Aarhus-University-MPE/Ice-Nucleation-Controller/src/Arduino/INCField/README.md

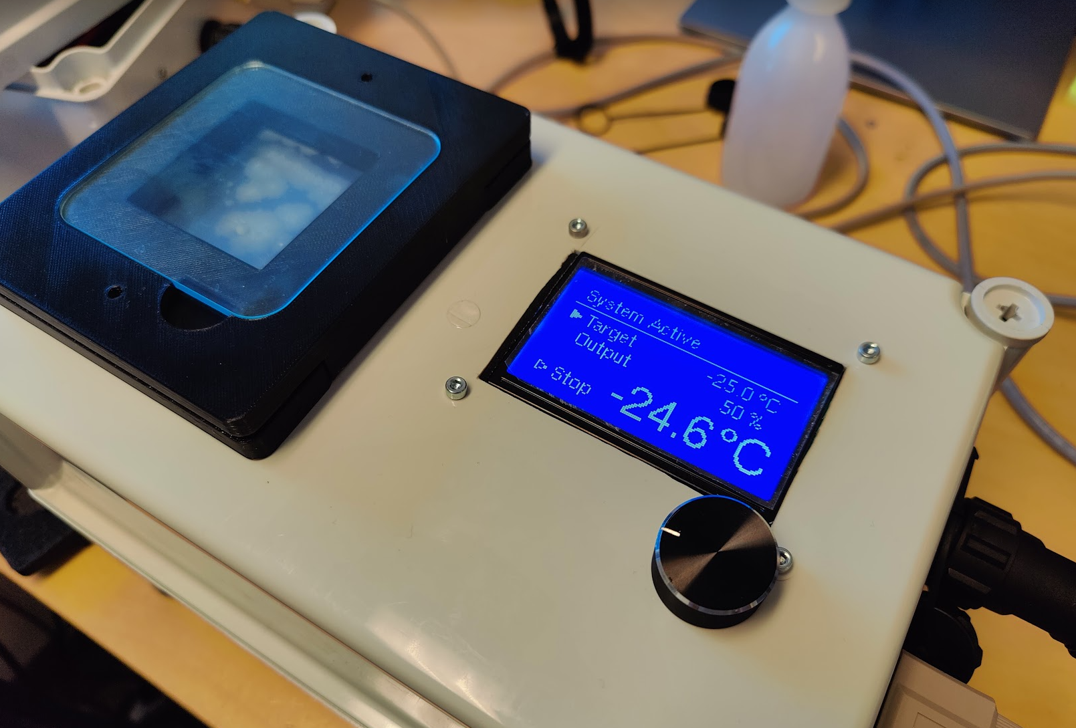
[picture p4: docs/assets/FieldController.png]


# Ice-Nucleation - Field Version

Reimagined Ice Nucleation system for field operation
