Aarhus-University-MPE/Ice-Nucleation-Controller/docs/assets/Cam_Tower_1.png

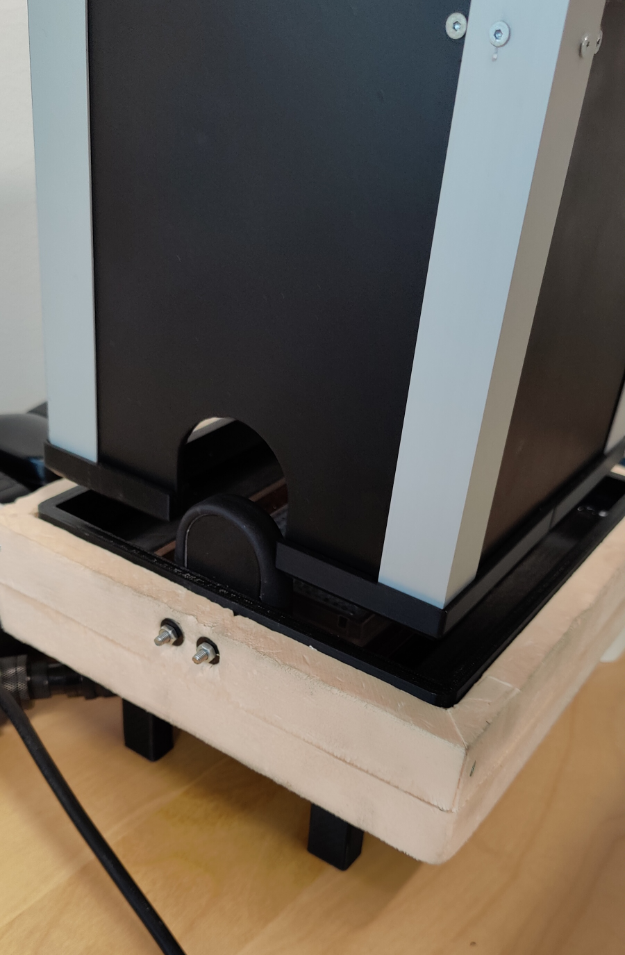
docs/assets/Cam_Tower_1.png
