Aarhus-University-MPE/Ice-Nucleation-Controller/docs/assets/Cam_Tower_2.png

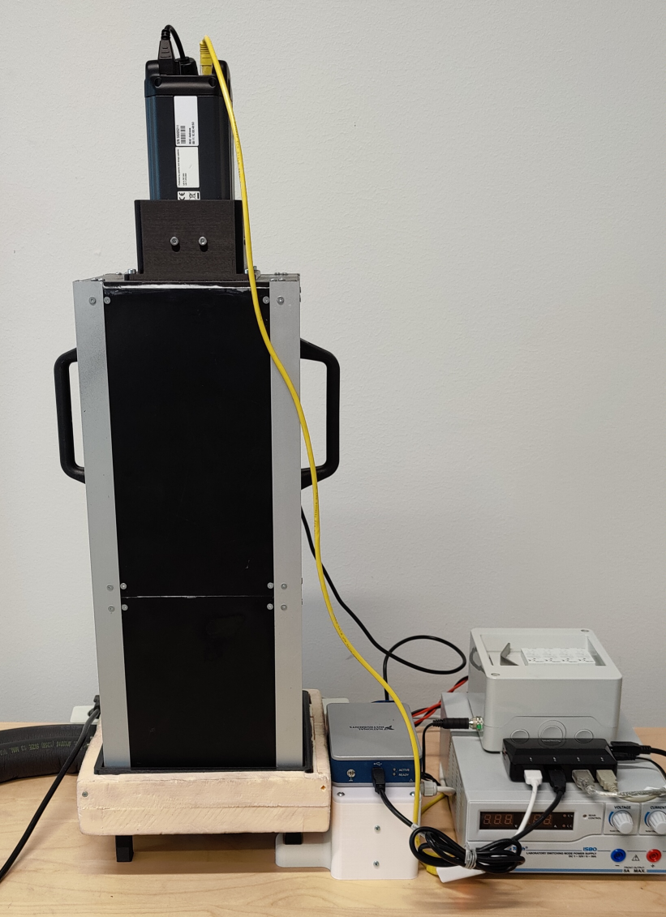
docs/assets/Cam_Tower_2.png
