Aarhus-University-MPE/Ice-Nucleation-Controller/docs/assets/Cam_Tower_Removed.png

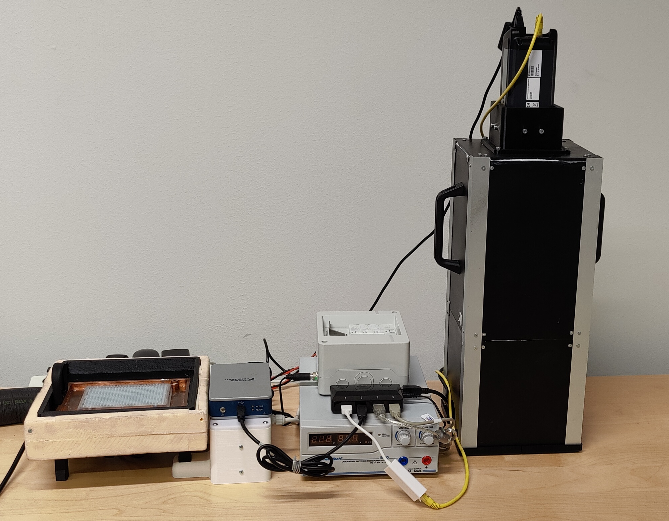
docs/assets/Cam_Tower_Removed.png
