Aarhus-University-MPE/Ice-Nucleation-Controller/docs/assets/CoolingCircuit.png

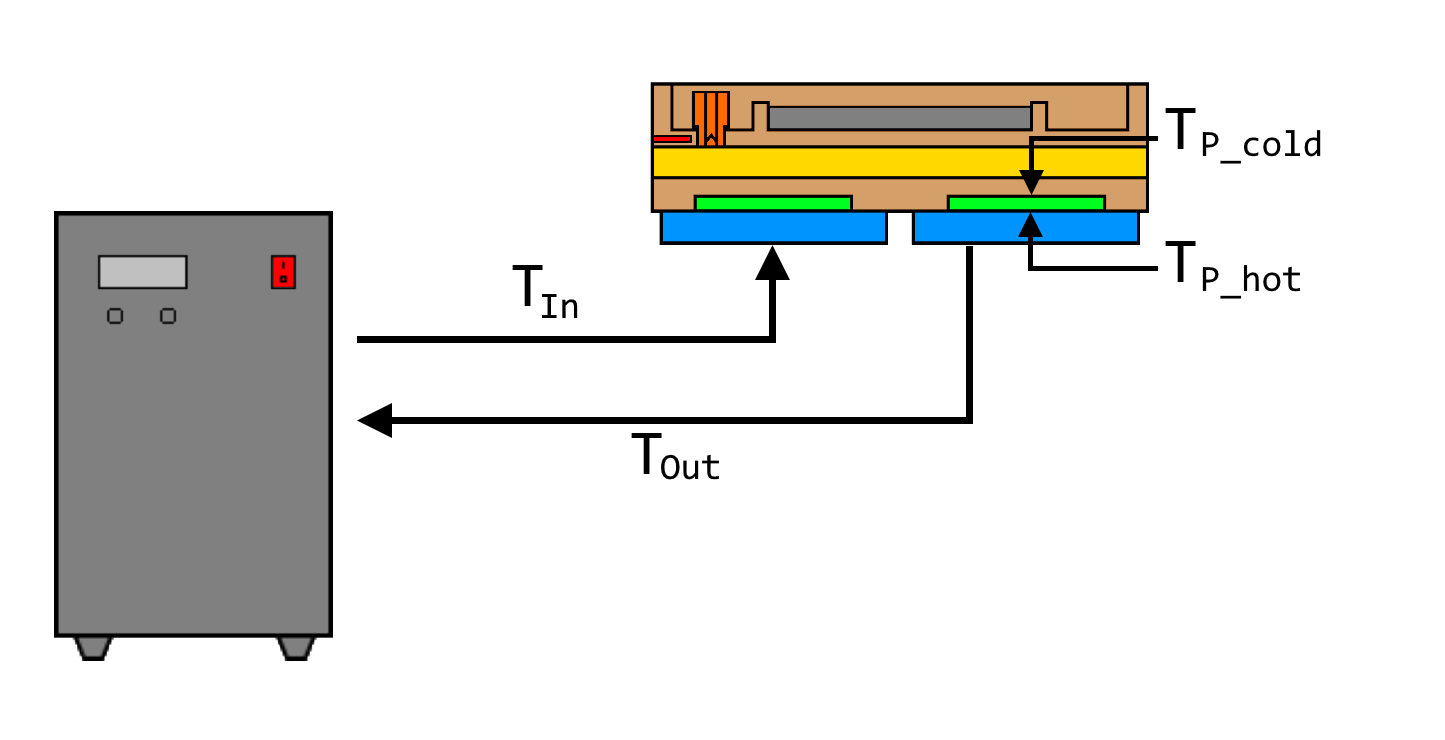
docs/assets/CoolingCircuit.png
