Aarhus-University-MPE/Ice-Nucleation-Controller/docs/assets/CoolingPump_On.png

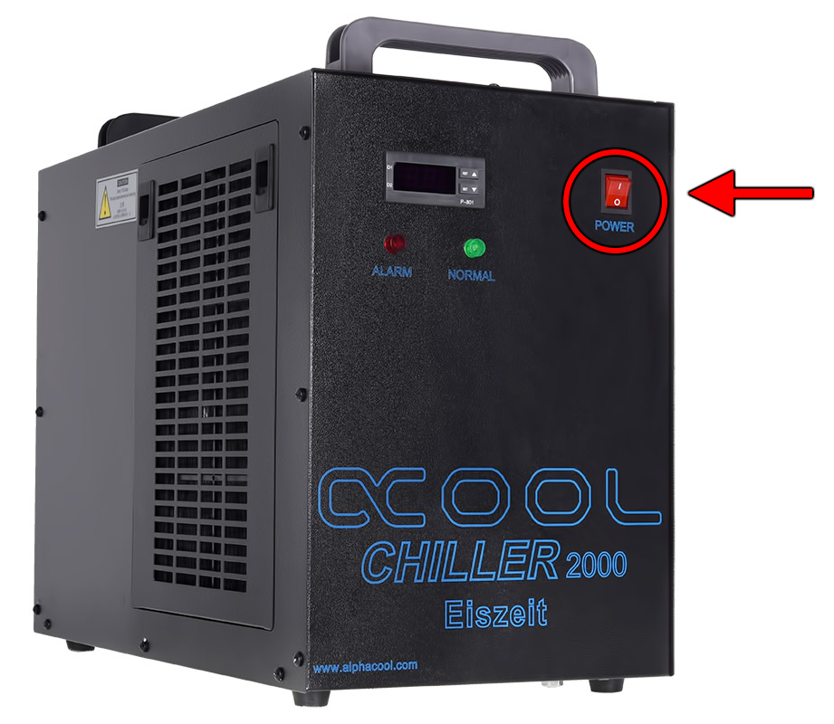
docs/assets/CoolingPump_On.png
