Aarhus-University-MPE/Ice-Nucleation-Controller/docs/assets/Crowbar_Remove.png

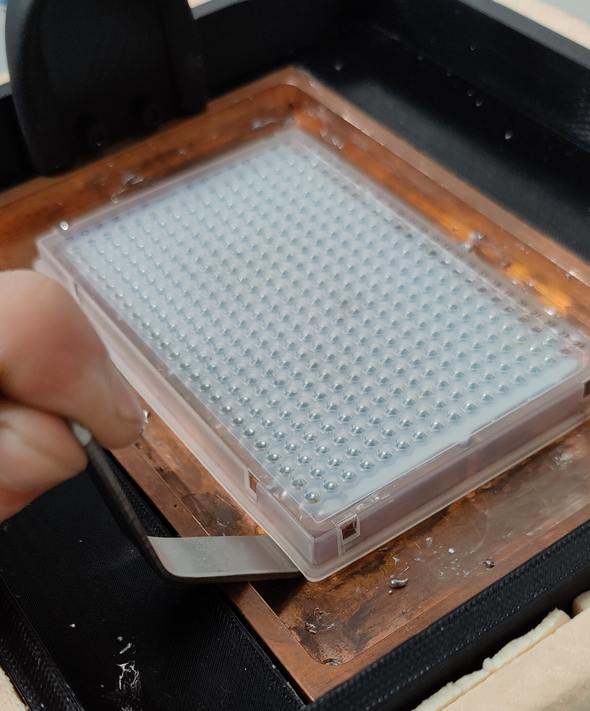
docs/assets/Crowbar_Remove.png
