Aarhus-University-MPE/Ice-Nucleation-Controller/docs/assets/Finger.png

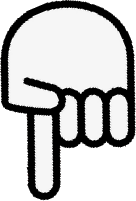
docs/assets/Finger.png
