Aarhus-University-MPE/Ice-Nucleation-Controller/docs/assets/FrozenFraction_Graph.png

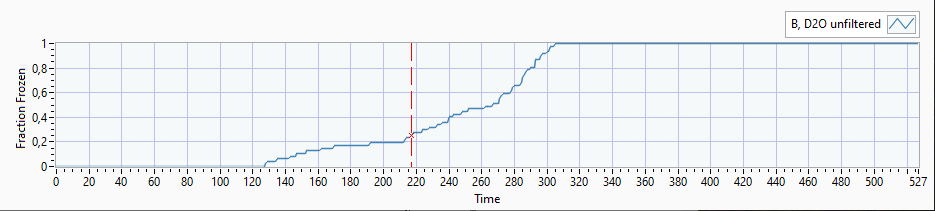
docs/assets/FrozenFraction_Graph.png
