Aarhus-University-MPE/Ice-Nucleation-Controller/docs/assets/FulllSlct.png

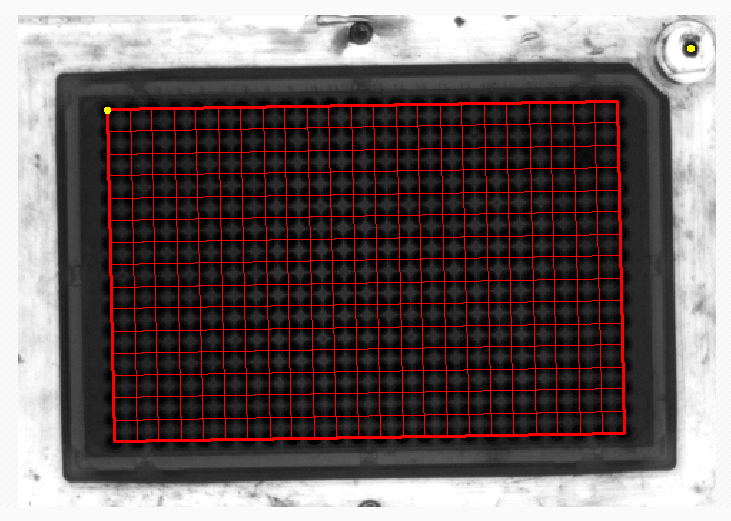
docs/assets/FulllSlct.png
