Aarhus-University-MPE/Ice-Nucleation-Controller/docs/assets/Gallium_Homogen.png

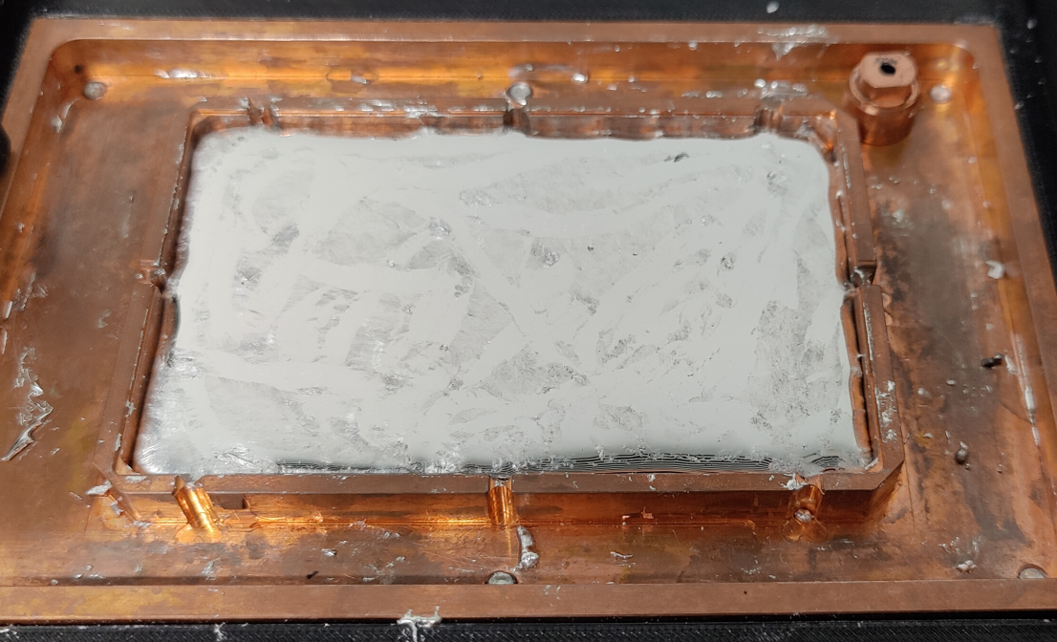
docs/assets/Gallium_Homogen.png
