Aarhus-University-MPE/Ice-Nucleation-Controller/docs/assets/Gallium_Melted.png

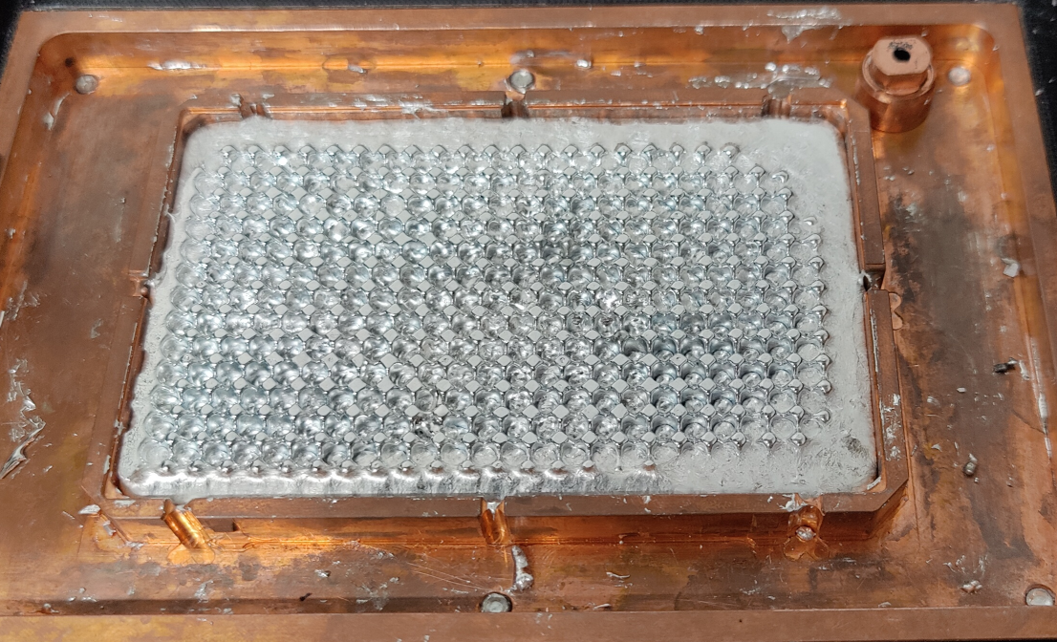
docs/assets/Gallium_Melted.png
