Aarhus-University-MPE/Ice-Nucleation-Controller/docs/assets/MainPowerPlug.png

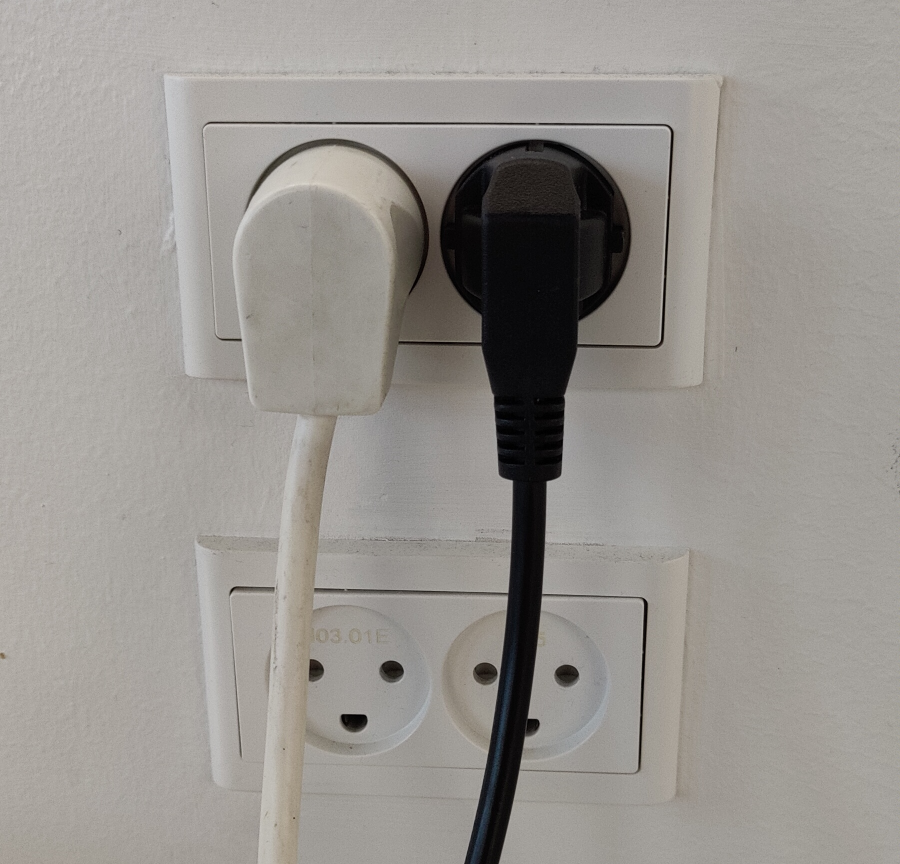
docs/assets/MainPowerPlug.png
