Aarhus-University-MPE/Ice-Nucleation-Controller/docs/assets/MeltingTemp.png

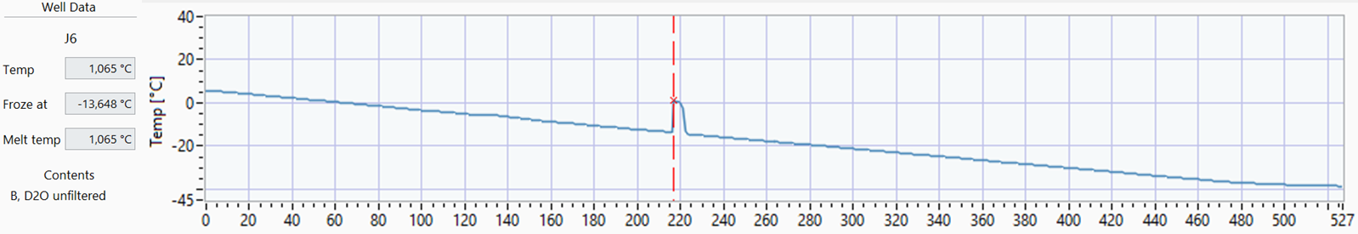
docs/assets/MeltingTemp.png
