Aarhus-University-MPE/Ice-Nucleation-Controller/docs/assets/PCR_Gallium_Level.png

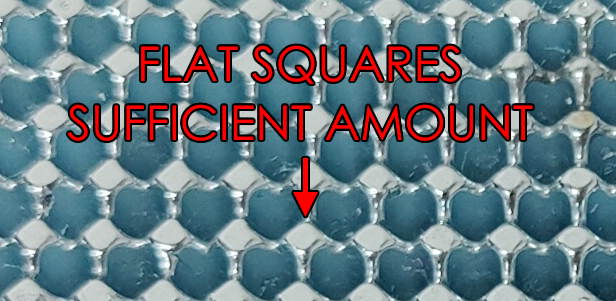
docs/assets/PCR_Gallium_Level.png
