Aarhus-University-MPE/Ice-Nucleation-Controller/docs/assets/PCR_Gallium_Leveled.png

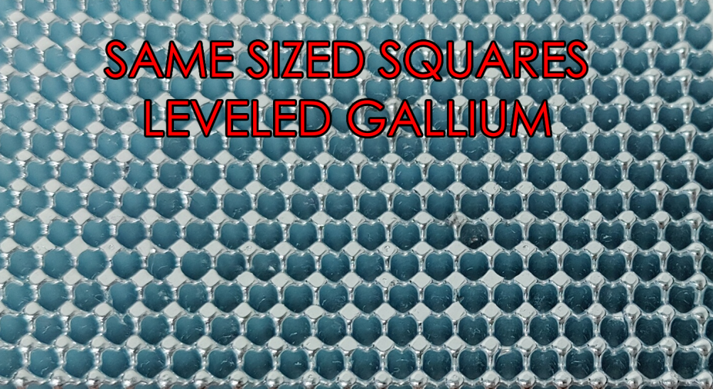
docs/assets/PCR_Gallium_Leveled.png
