Aarhus-University-MPE/Ice-Nucleation-Controller/docs/assets/PCR_Pipette.png

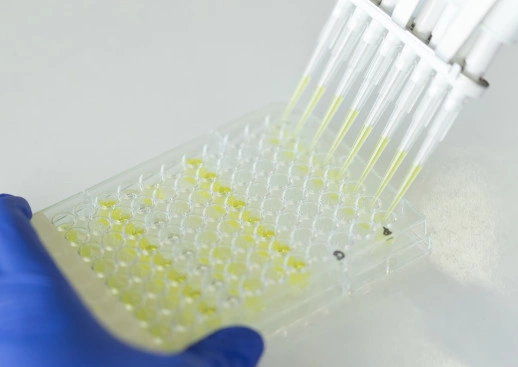
docs/assets/PCR_Pipette.png
