Aarhus-University-MPE/Ice-Nucleation-Controller/docs/assets/PCR_Press.png

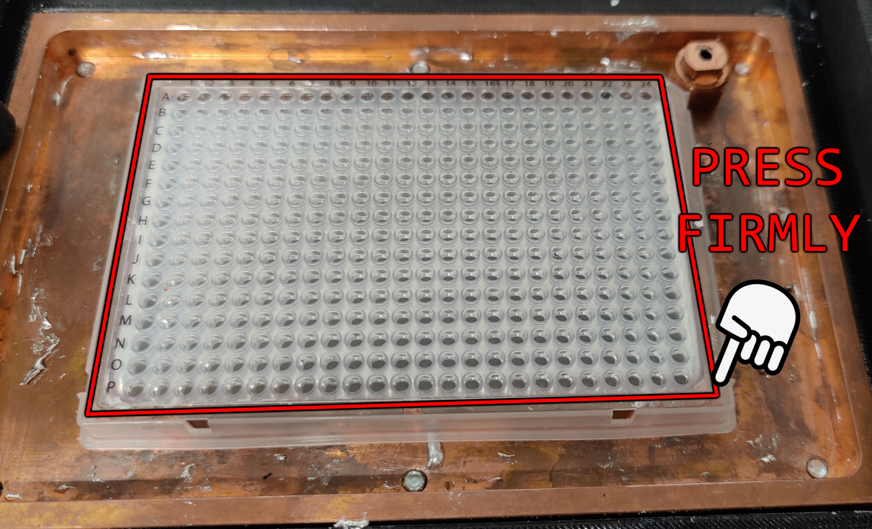
docs/assets/PCR_Press.png
