Aarhus-University-MPE/Ice-Nucleation-Controller/docs/assets/PCR_Press_No_Center.png

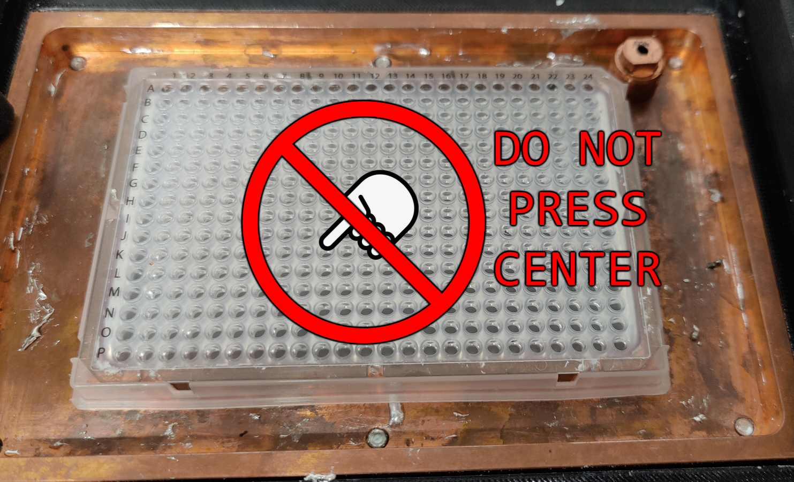
docs/assets/PCR_Press_No_Center.png
