Aarhus-University-MPE/Ice-Nucleation-Controller/docs/assets/PCR_Ready.png

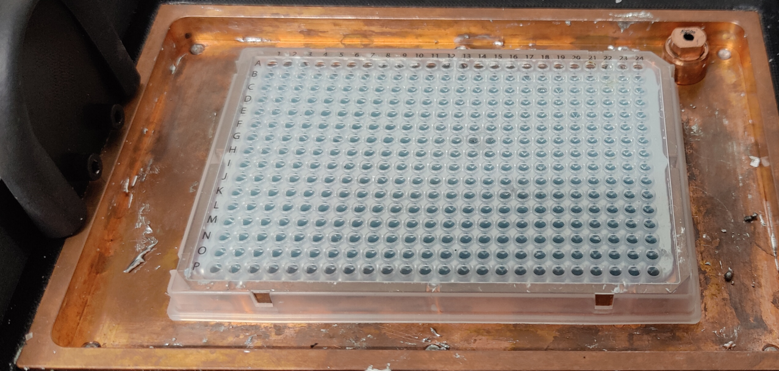
docs/assets/PCR_Ready.png
