Aarhus-University-MPE/Ice-Nucleation-Controller/docs/assets/PCR_Removed.png

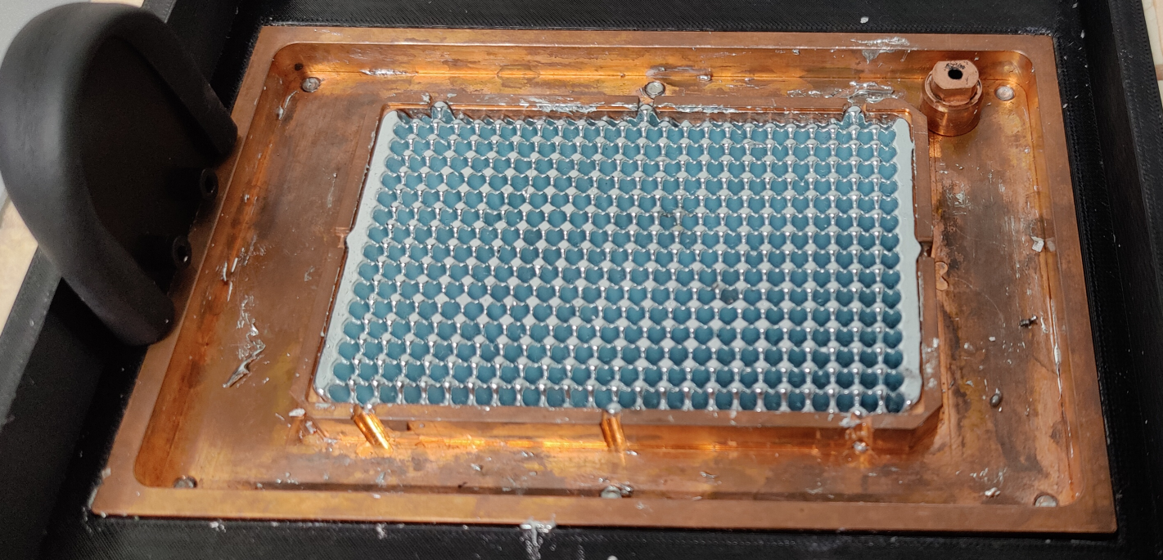
docs/assets/PCR_Removed.png
