Aarhus-University-MPE/Ice-Nucleation-Controller/docs/assets/PCR_Weight_Lid.png

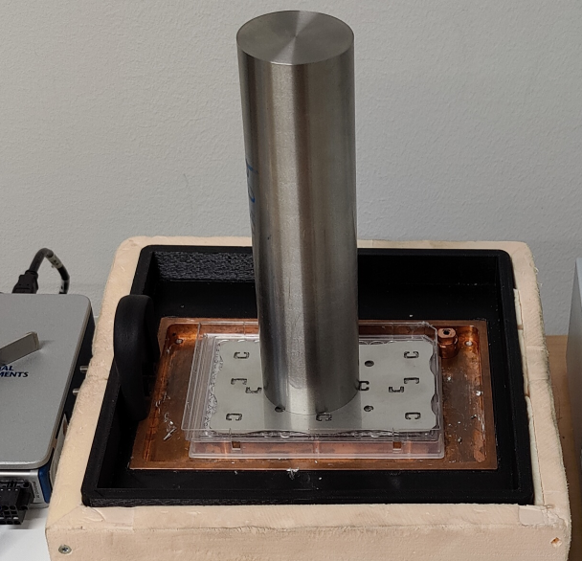
docs/assets/PCR_Weight_Lid.png
