Aarhus-University-MPE/Ice-Nucleation-Controller/docs/assets/PeltierSwitchRelay.png

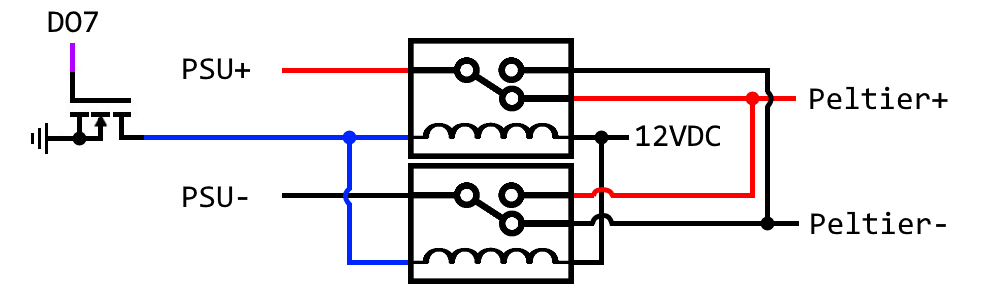
docs/assets/PeltierSwitchRelay.png
