Aarhus-University-MPE/Ice-Nucleation-Controller/docs/assets/PSU_On.png

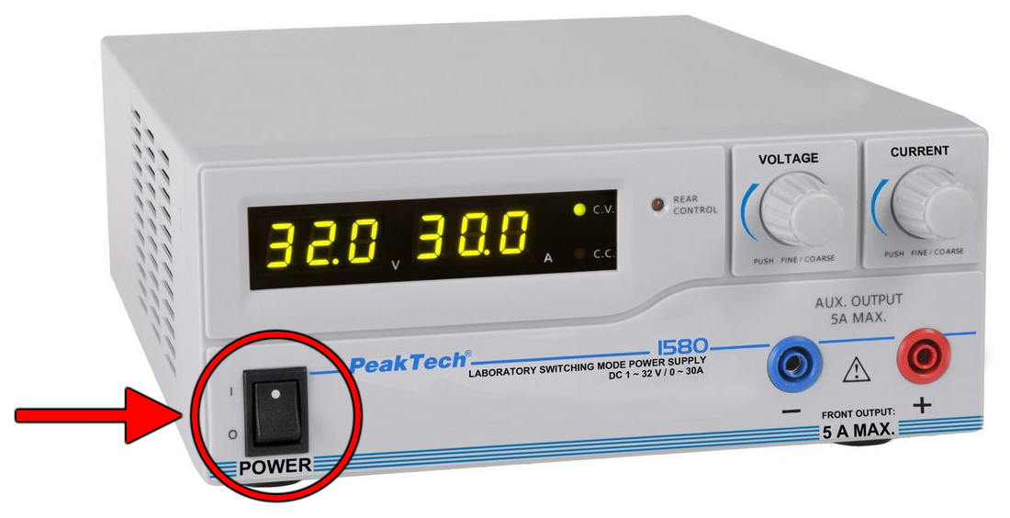
docs/assets/PSU_On.png
