Aarhus-University-MPE/Ice-Nucleation-Controller/docs/assets/SaveSelection.png

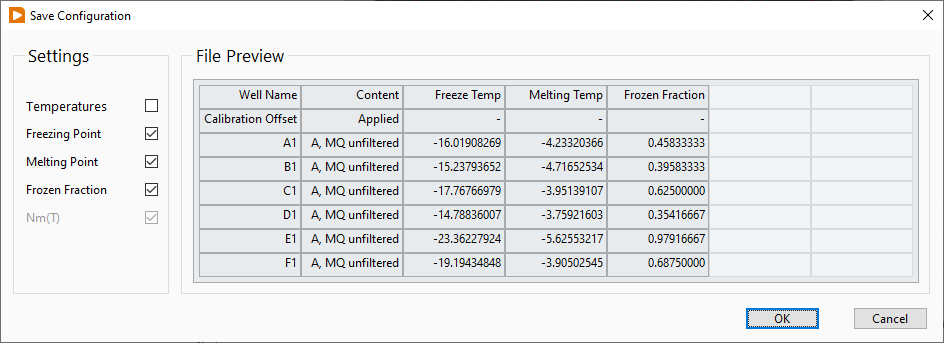
docs/assets/SaveSelection.png
