Aarhus-University-MPE/Ice-Nucleation-Controller/docs/assets/System2.png

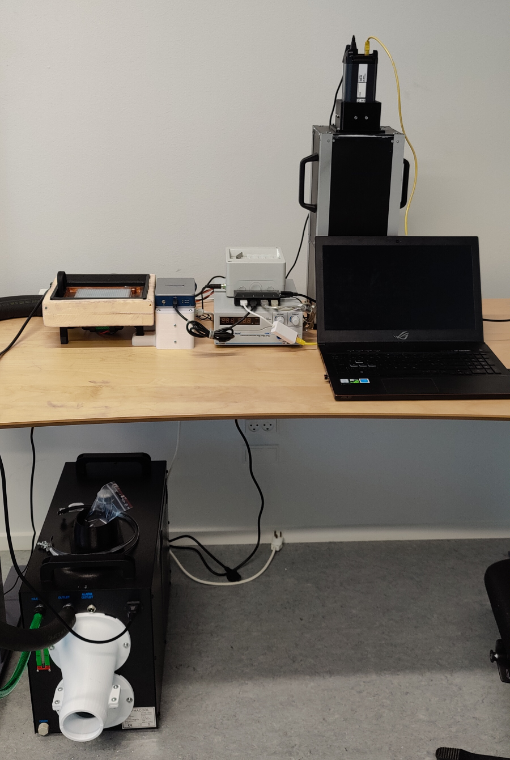
docs/assets/System2.png
