Aarhus-University-MPE/Ice-Nucleation-Controller/docs/assets/System.png

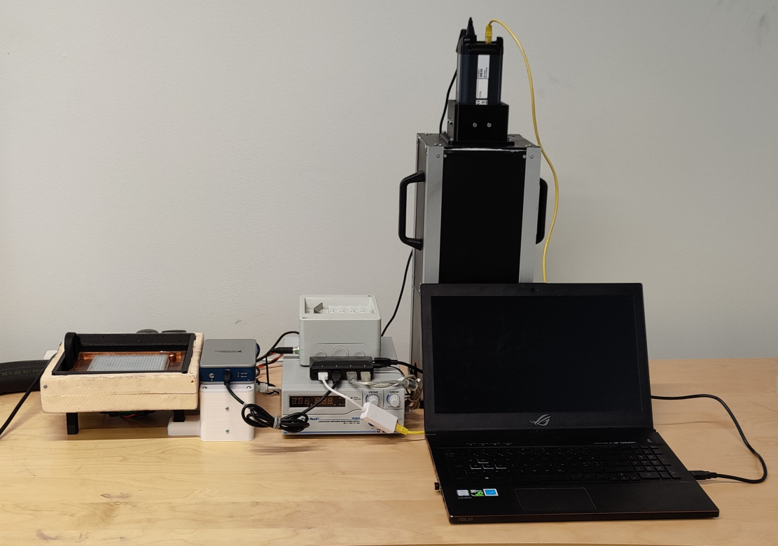
docs/assets/System.png
