Aarhus-University-MPE/Ice-Nucleation-Controller/docs/assets/System_CoolingBase.png

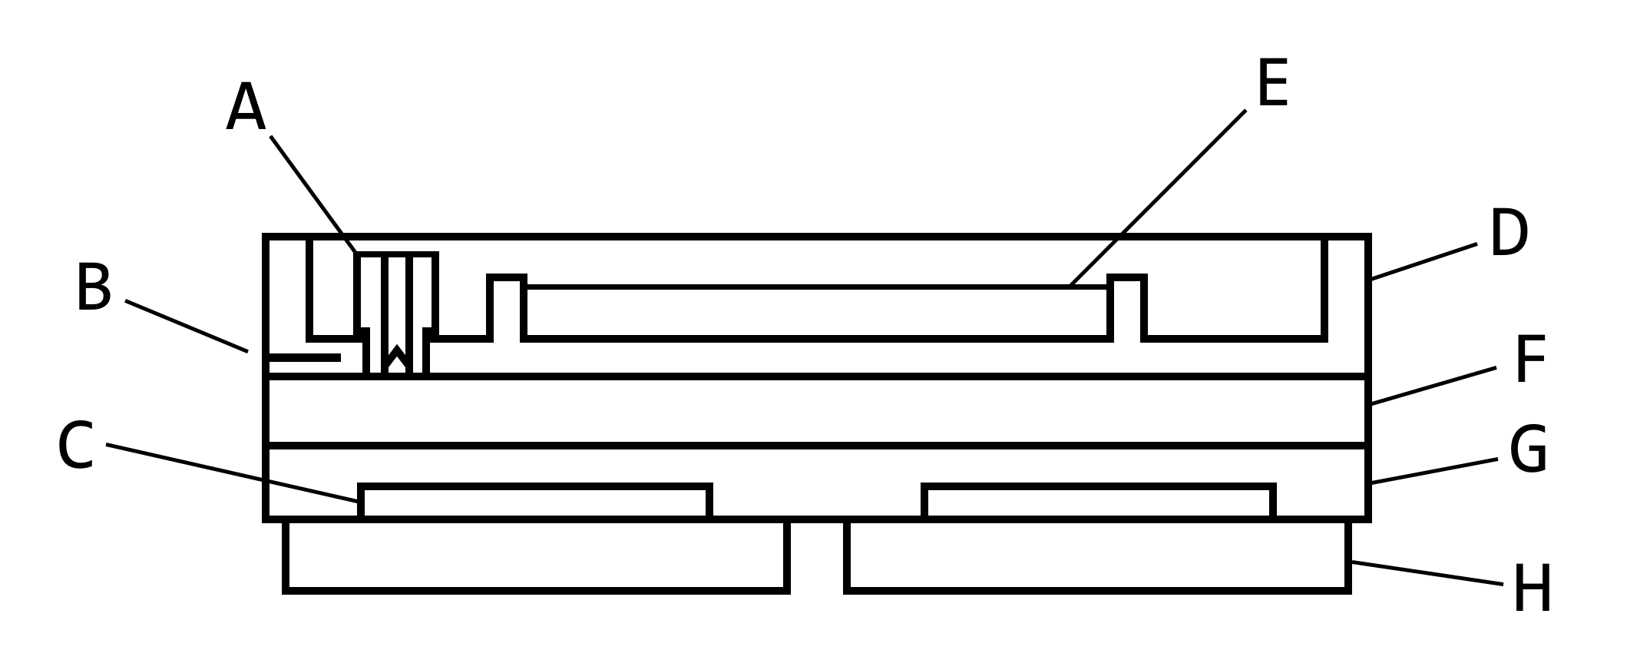
docs/assets/System_CoolingBase.png
