Aarhus-University-MPE/Ice-Nucleation-Controller/docs/assets/System_Water.png

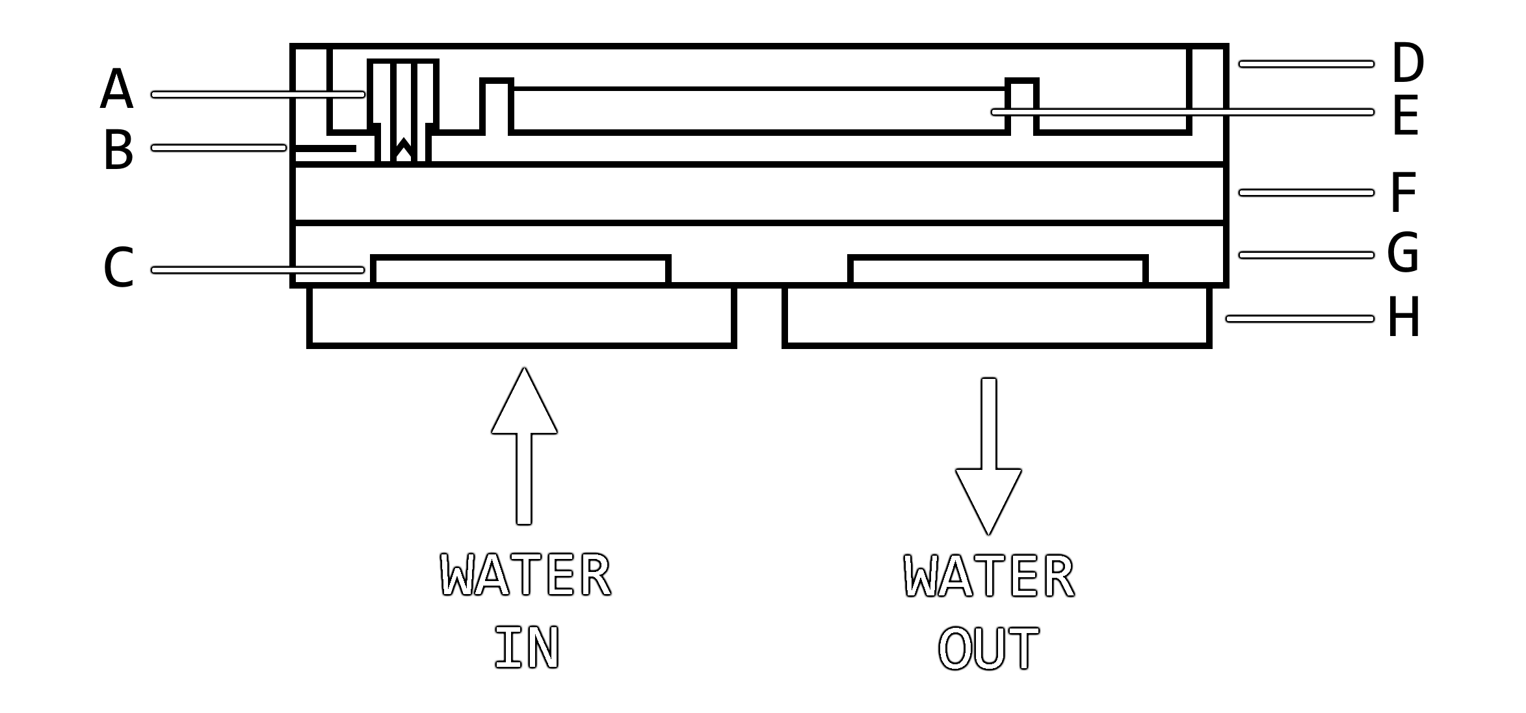
docs/assets/System_Water.png
