Aarhus-University-MPE/Ice-Nucleation-Controller/docs/assets/SystemData.png

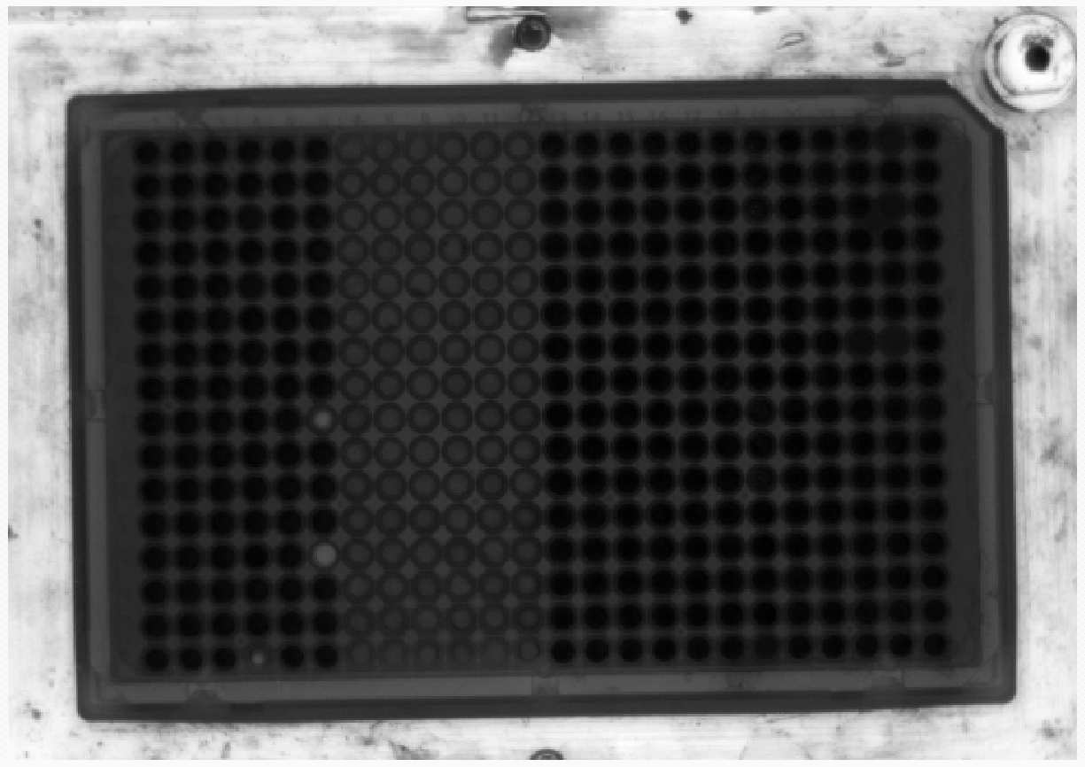
docs/assets/SystemData.png
