Aarhus-University-MPE/Ice-Nucleation-Controller/docs/assets/SystemDescription.png

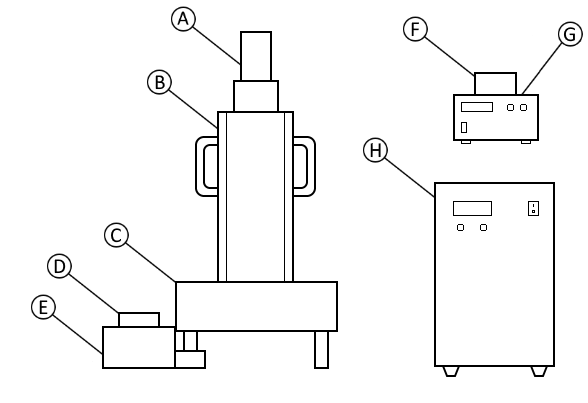
docs/assets/SystemDescription.png
