Aarhus-University-MPE/Ice-Nucleation-Controller/docs/assets/T_Residual_Final_Plot.png

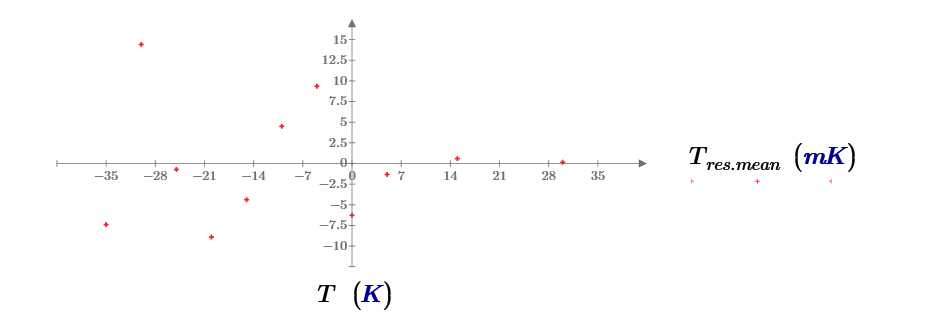
docs/assets/T_Residual_Final_Plot.png
