Aarhus-University-MPE/Ice-Nucleation-Controller/docs/assets/T_Vout_Plot.png

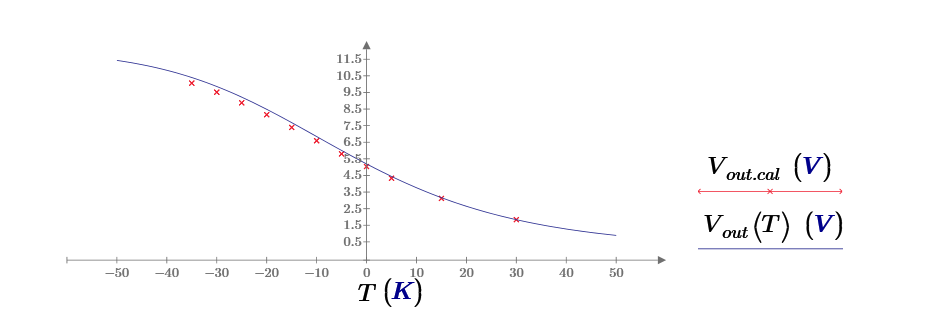
docs/assets/T_Vout_Plot.png
