Aarhus-University-MPE/Ice-Nucleation-Controller/docs/assets/T_Vout_Plot_Theoretical.png

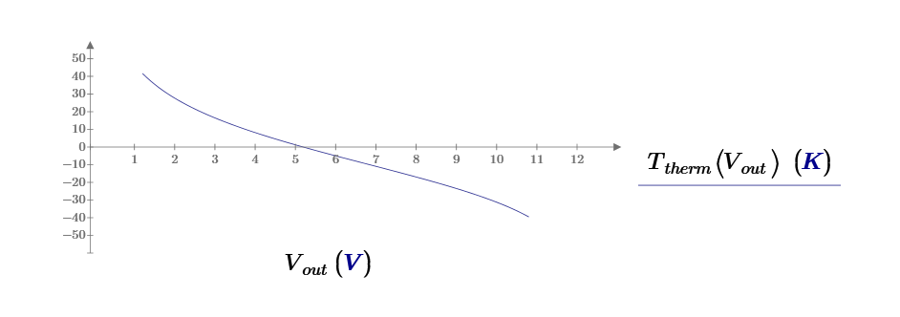
docs/assets/T_Vout_Plot_Theoretical.png
