Aarhus-University-MPE/Ice-Nucleation-Controller/docs/assets/TCC_ImageSettings.png

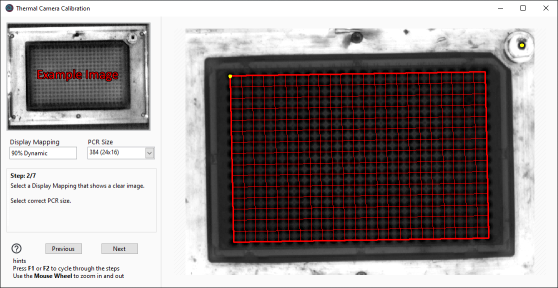
docs/assets/TCC_ImageSettings.png
