Aarhus-University-MPE/Ice-Nucleation-Controller/docs/assets/TCC_Main.png

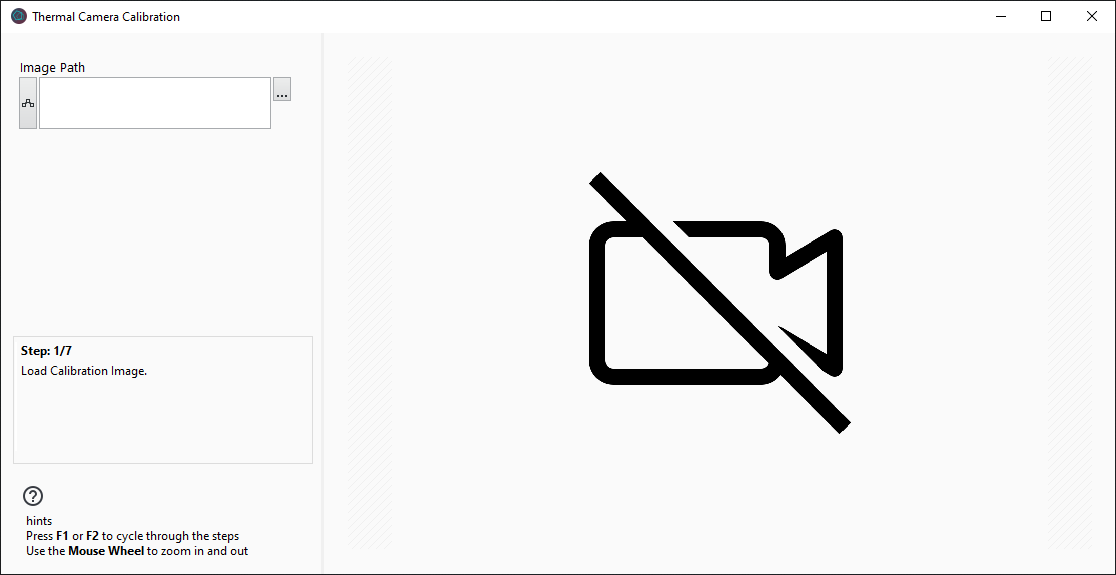
docs/assets/TCC_Main.png
