Aarhus-University-MPE/Ice-Nucleation-Controller/docs/assets/TCC_WellRadius.png

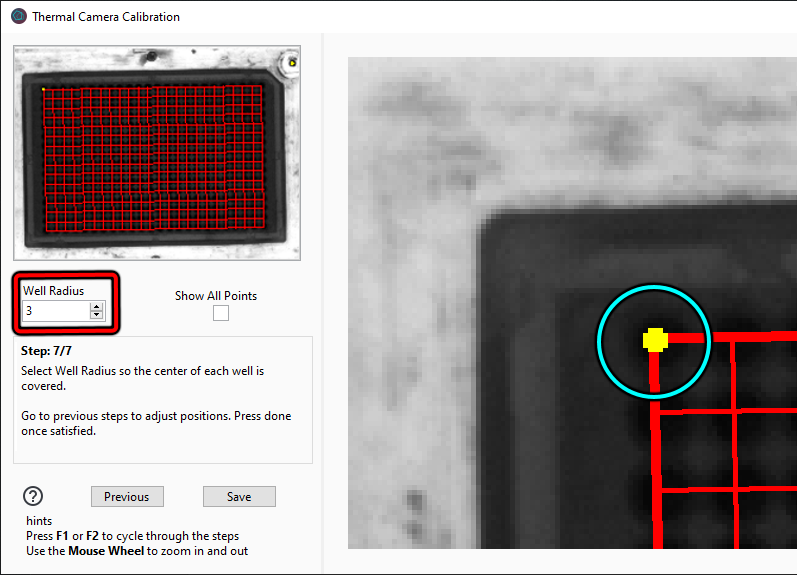
docs/assets/TCC_WellRadius.png
