Aarhus-University-MPE/Ice-Nucleation-Controller/docs/assets/TCE_Focus.png

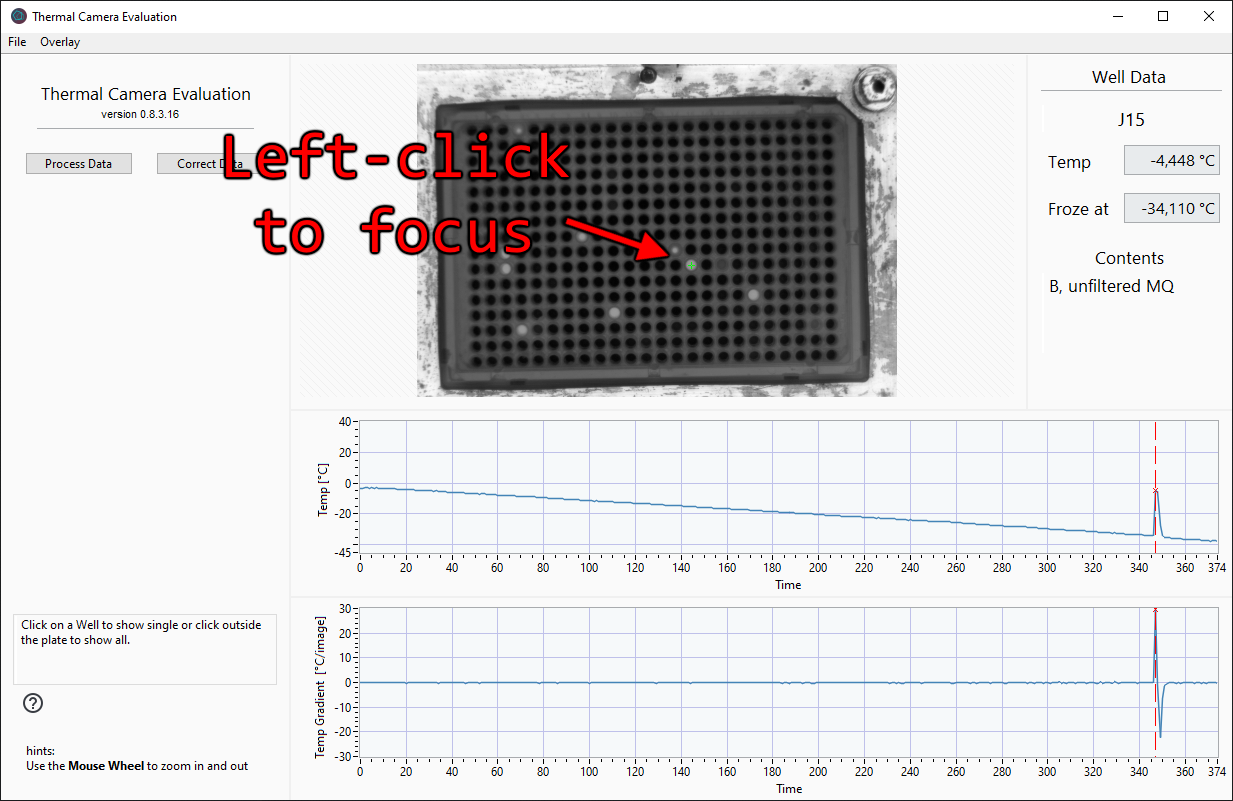
docs/assets/TCE_Focus.png
