Aarhus-University-MPE/Ice-Nucleation-Controller/docs/assets/TCE_Main.png

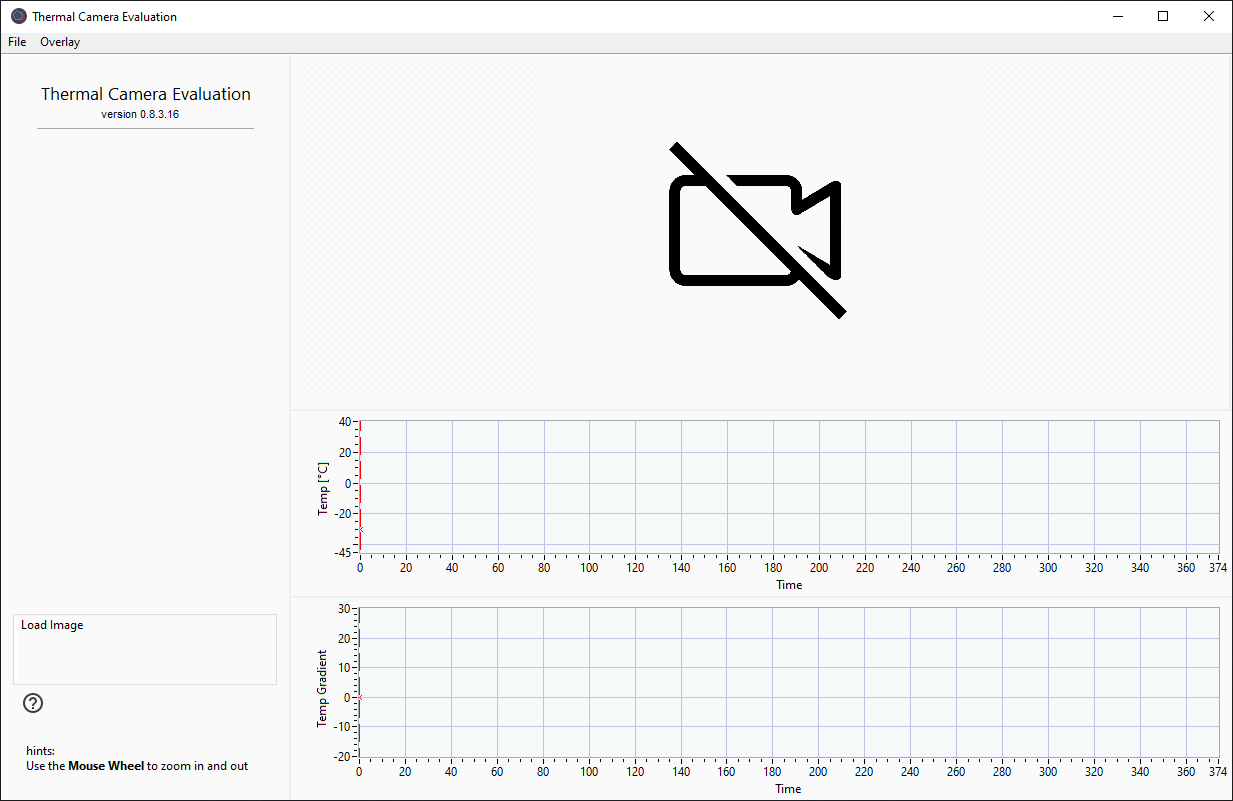
docs/assets/TCE_Main.png
