Aarhus-University-MPE/Ice-Nucleation-Controller/docs/assets/TCE_Navigate.png

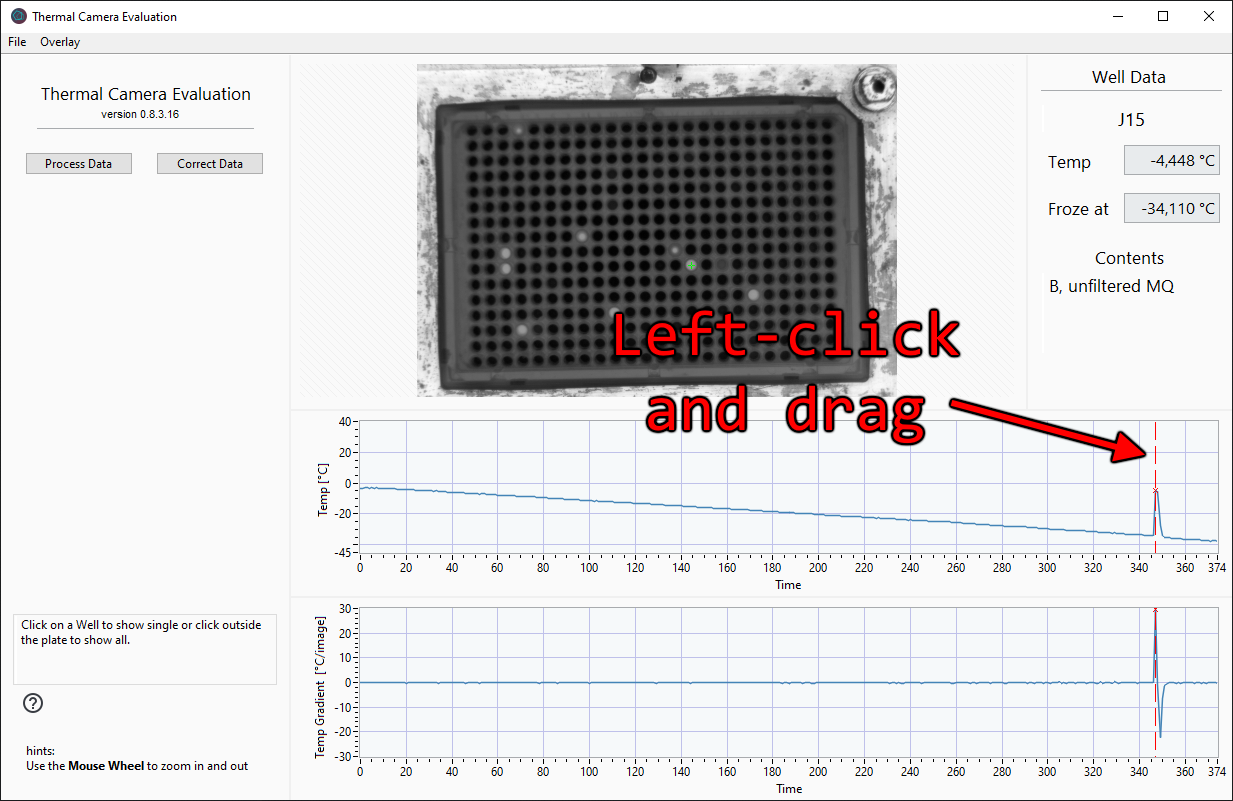
docs/assets/TCE_Navigate.png
