Aarhus-University-MPE/Ice-Nucleation-Controller/docs/assets/TCE_Overlay_1.png

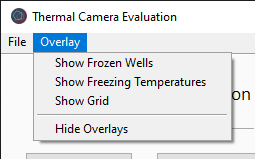
docs/assets/TCE_Overlay_1.png
