Aarhus-University-MPE/Ice-Nucleation-Controller/docs/assets/TCE_Overlay_2.png

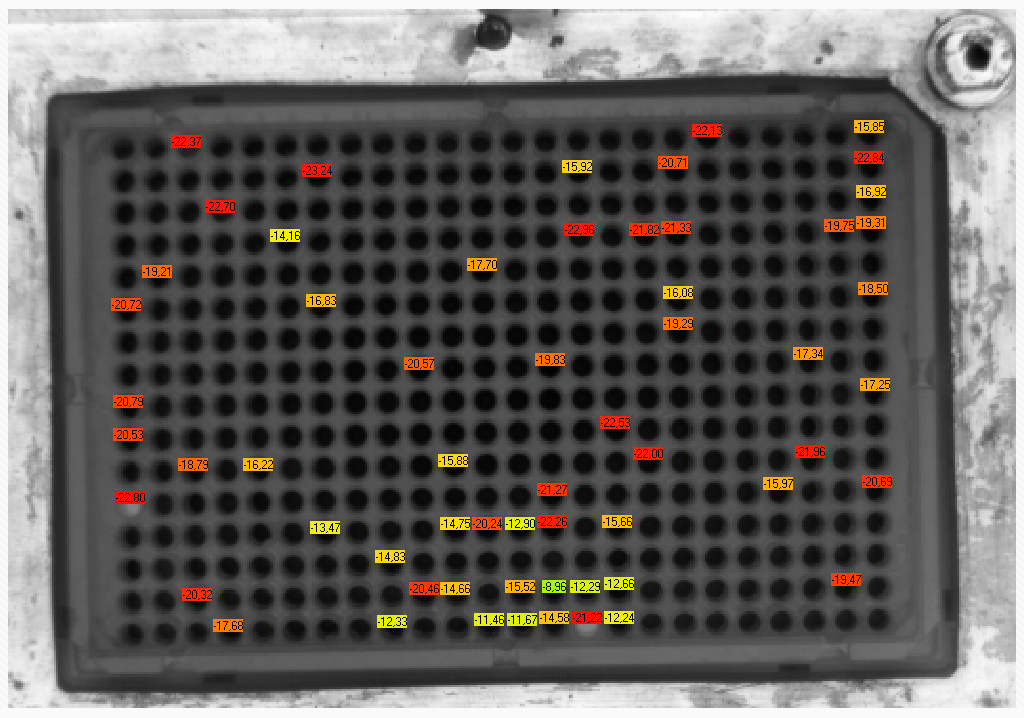
docs/assets/TCE_Overlay_2.png
