Aarhus-University-MPE/Ice-Nucleation-Controller/docs/assets/TCE_Process_1.png

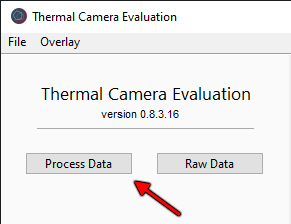
docs/assets/TCE_Process_1.png
