Aarhus-University-MPE/Ice-Nucleation-Controller/docs/assets/TCE_Process_2.png

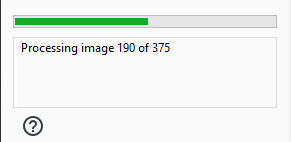
docs/assets/TCE_Process_2.png
