Aarhus-University-MPE/Ice-Nucleation-Controller/docs/assets/TCE_Recent.png

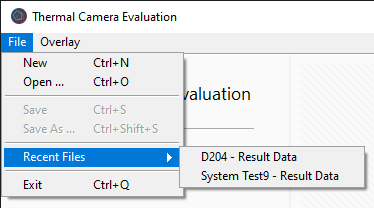
docs/assets/TCE_Recent.png
