Aarhus-University-MPE/Ice-Nucleation-Controller/docs/assets/TCE_Save.png

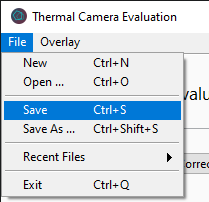
docs/assets/TCE_Save.png
