Aarhus-University-MPE/Ice-Nucleation-Controller/docs/assets/ThermistorCircuit.png

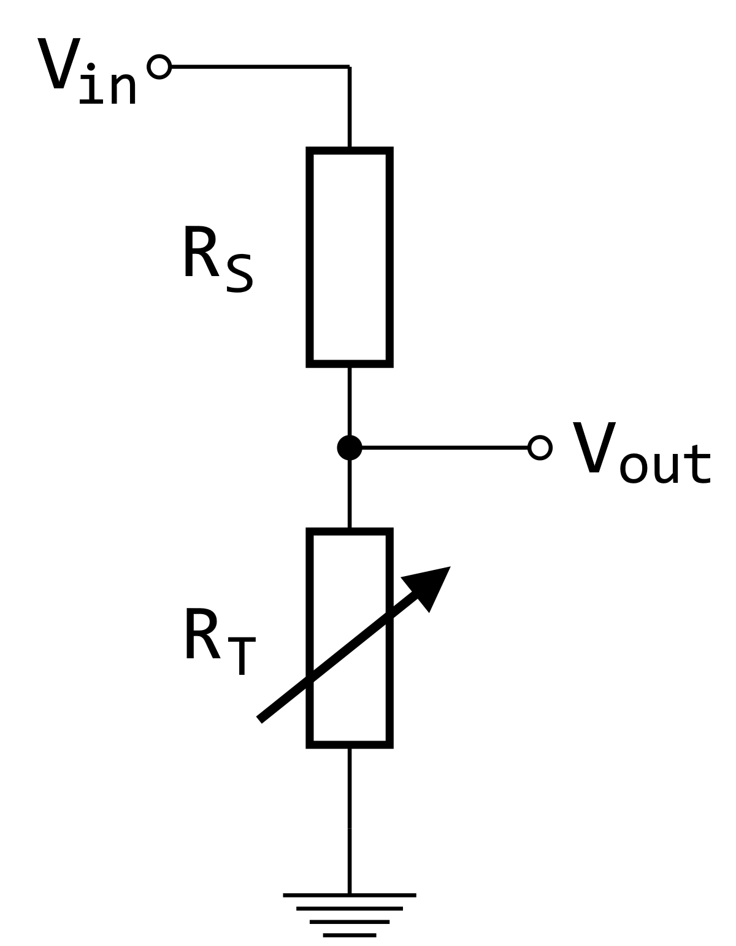
docs/assets/ThermistorCircuit.png
