Aarhus-University-MPE/Ice-Nucleation-Controller/docs/assets/UI_Partition.png

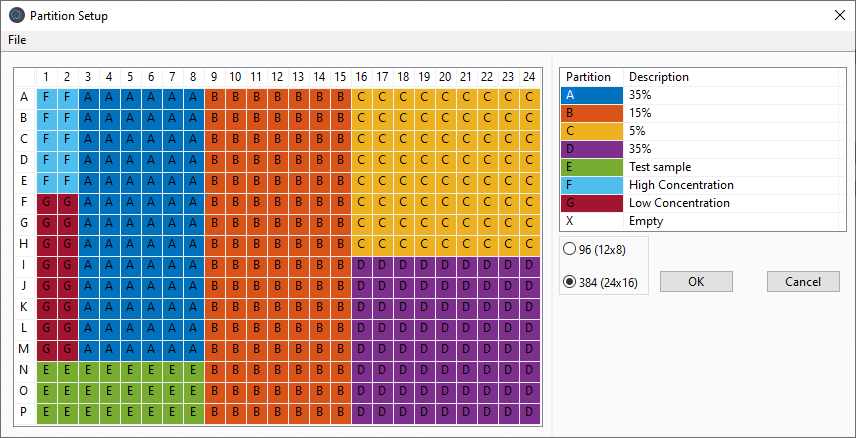
docs/assets/UI_Partition.png
