Aarhus-University-MPE/Ice-Nucleation-Controller/docs/assets/UI_Partition_Description.png

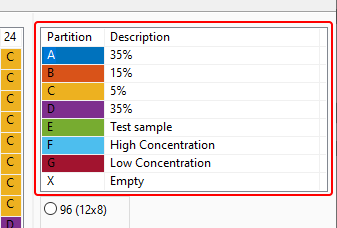
docs/assets/UI_Partition_Description.png
