Aarhus-University-MPE/Ice-Nucleation-Controller/docs/assets/UI_Partition_Marking.png

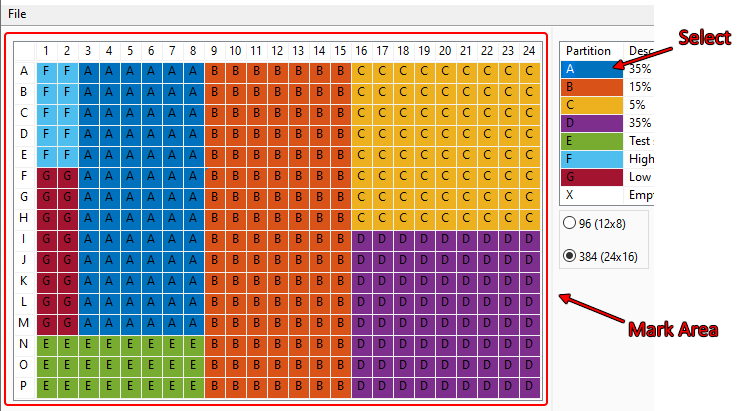
docs/assets/UI_Partition_Marking.png
