Aarhus-University-MPE/Ice-Nucleation-Controller/docs/assets/UI_Partition_Size.png

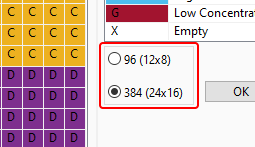
docs/assets/UI_Partition_Size.png
