Aarhus-University-MPE/Ice-Nucleation-Controller/docs/assets/UI_Temp_Freeze.png

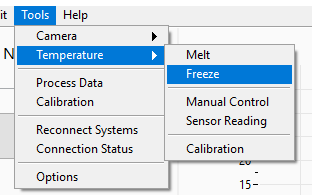
docs/assets/UI_Temp_Freeze.png
