Aarhus-University-MPE/Ice-Nucleation-Controller/docs/assets/UI_Temp_Melt.png

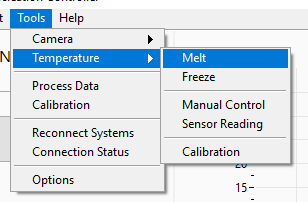
docs/assets/UI_Temp_Melt.png
