Aarhus-University-MPE/Ice-Nucleation-Controller/docs/assets/USB_PC_Connect.png

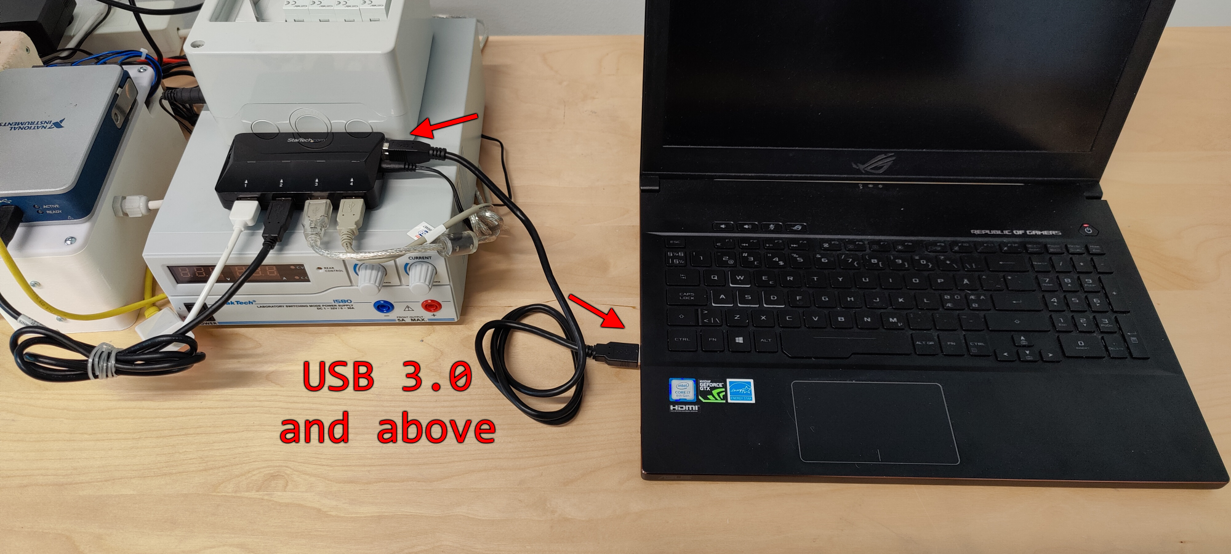
docs/assets/USB_PC_Connect.png
