Aarhus-University-MPE/Ice-Nucleation-Controller/src/LabVIEW/camera_placeholder.png

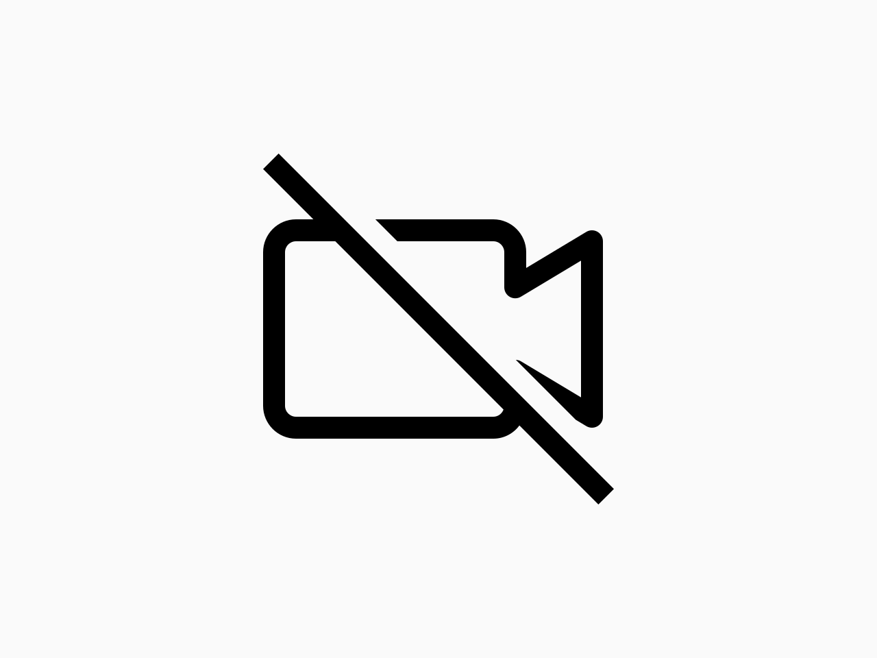
src/LabVIEW/camera_placeholder.png
