Aarhus-University-MPE/Ice-Nucleation-Controller/src/LabVIEW/resources/BottomLeftSlct.png

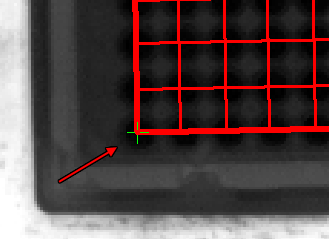
src/LabVIEW/resources/BottomLeftSlct.png
