Aarhus-University-MPE/Ice-Nucleation-Controller/src/LabVIEW/resources/CavitySlct2.png

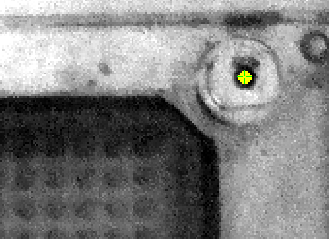
src/LabVIEW/resources/CavitySlct2.png
