Aarhus-University-MPE/Ice-Nucleation-Controller/src/LabVIEW/resources/Crystals_Only.png

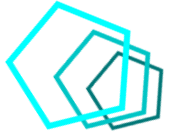
src/LabVIEW/resources/Crystals_Only.png
