Aarhus-University-MPE/Ice-Nucleation-Controller/src/LabVIEW/resources/FulllSlct.png

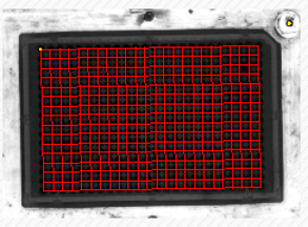
src/LabVIEW/resources/FulllSlct.png
