Aarhus-University-MPE/Ice-Nucleation-Controller/src/LabVIEW/resources/ImageLoad.png

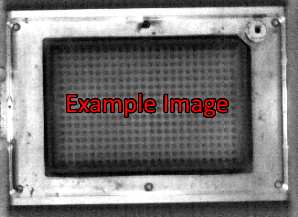
src/LabVIEW/resources/ImageLoad.png
