Aarhus-University-MPE/Ice-Nucleation-Controller/src/LabVIEW/resources/TopLeftSlct.png

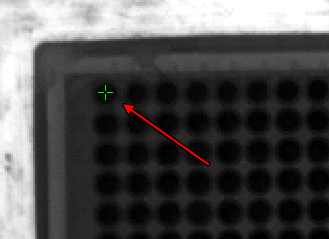
src/LabVIEW/resources/TopLeftSlct.png
