Aarhus-University-MPE/Ice-Nucleation-Controller/src/LabVIEW/resources/TopRightSlct.png

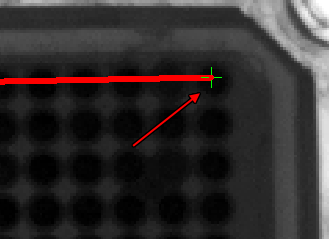
src/LabVIEW/resources/TopRightSlct.png
