Aarhus-University-MPE/Ice-Nucleation-Controller/(list of files, cad)

Other CAD files:
src/LabVIEW/Partitions/Big Setup.prt
src/LabVIEW/Partitions/Partition Setup.prt
src/LabVIEW/Partitions/Small Setup.prt
