Aarhus-University-MPE/Ice-Nucleation-Controller/docs/Calibration Data/Sensor 1,5,6,7,8/Calibration_13/Setup.csv

Ice Nucleation Version | 1.4.11.87
Sample:
Label | Calibration_13
Operator | MRJ
Date | 2021_08_16_11-26
PCR type | 24x16
Sample volume [µL] | 1,00
Temperature Gradient [°C/min] | -1,00
Target Temperature [°C] | 0,00
Starting Temp [°C] | 8,980556
Ending Temp [°C] | 10,083770
Test Duration [mm:ss] | 05:59
PID setup:
Proportional Gain | 1,000000
Integral time (min) | 0,010000
Derivative time (min) | 0,000000
Calibration Values:
B0_100 | 3711,100000 | 3750,100000 | 3743,800000 | 3749,400000 | 3976,000000 | 3976,000000 | 3976,000000 | 3976,000000
R25 | 2,321600 | 2,265200 | 2,263400 | 2,263400 | 2,252000 | 2,252000 | 2,252000 | 2,252000
R_S | 10,000000
Notes:
Thermistor 1,5,6,7,8 inserted into calibrator
Thermistor 2: reference voltage
AMETEK Calibrator
SN: 660141-00935
