Aarhus-University-MPE/Ice-Nucleation-Controller/docs/assets/UI_Menu_Setup.png

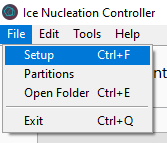
docs/assets/UI_Menu_Setup.png
