Aarhus-University-MPE/Ice-Nucleation-Controller/docs/assets/UI_Setup.png

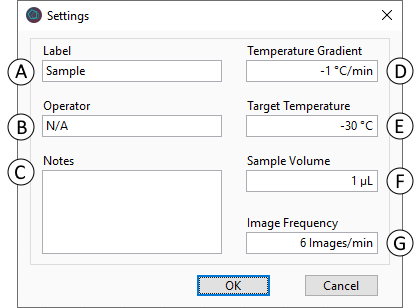
docs/assets/UI_Setup.png
