Aarhus-University-MPE/Ice-Nucleation-Controller/docs/Calibration Data/Sensor 1,5,6,7,8/Calibration_0/Data.csv

Time [MM:SS] | Image file path | T1 | T2 | T3 | T4 | T5 | T6 | T7 | T8 | V1 | V2 | V3 | V4 | V5 | V6 | V7 | V8
08-43-04_235 | C:\Users\au540322\Documents\Projects\Ice-Nucleation\Builds\Full Build\Data\Calibration_0/Images/08-43-04_235.PNG | 31,383423 | NaN | 26,107306 | 26,248709 | 30,207304 | 30,292408 | 30,256215 | 30,174320 | 1,833688 | 12,006062 | 2,147547 | 2,137022 | 1,837084 | 1,831367 | 1,833796 | 1,839305
08-43-04_735 | C:\Users\au540322\Documents\Projects\Ice-Nucleation\Builds\Full Build\Data\Calibration_0/Images/08-43-04_735.PNG | 31,384017 | NaN | 26,111159 | 26,268669 | 30,206861 | 30,292541 | 30,255337 | 30,174585 | 1,833651 | 12,006071 | 2,147263 | 2,135555 | 1,837114 | 1,831358 | 1,833855 | 1,839287
08-43-05_234 | C:\Users\au540322\Documents\Projects\Ice-Nucleation\Builds\Full Build\Data\Calibration_0/Images/08-43-05_234.PNG | 31,383816 | NaN | 26,113195 | 26,287692 | 30,206843 | 30,292168 | 30,256819 | 30,175390 | 1,833664 | 12,006053 | 2,147113 | 2,134157 | 1,837115 | 1,831383 | 1,833755 | 1,839233
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
