Aarhus-University-MPE/Ice-Nucleation-Controller/docs/Calibration Data/Sensor 1,5,6,7,8/Calibration_10/Data.csv

Time [MM:SS] | Image file path | T1 | T2 | T3 | T4 | T5 | T6 | T7 | T8 | V1 | V2 | V3 | V4 | V5 | V6 | V7 | V8
09-40-21_232 | C:\Users\au540322\Documents\Projects\Ice-Nucleation\Builds\Full Build\Data\Calibration_10/Images/09-40-21_232.PNG | 31,378203 | NaN | 25,345748 | 29,393890 | 30,203495 | 30,284572 | 30,244407 | 30,165501 | 1,834013 | 12,005705 | 2,204465 | 1,917626 | 1,837341 | 1,831892 | 1,834589 | 1,839900
09-40-21_732 | C:\Users\au540322\Documents\Projects\Ice-Nucleation\Builds\Full Build\Data\Calibration_10/Images/09-40-21_732.PNG | 31,377868 | NaN | 25,349875 | 29,392437 | 30,202946 | 30,284865 | 30,245143 | 30,165368 | 1,834034 | 12,005695 | 2,204152 | 1,917722 | 1,837378 | 1,831873 | 1,834540 | 1,839908
09-40-22_232 | C:\Users\au540322\Documents\Projects\Ice-Nucleation\Builds\Full Build\Data\Calibration_10/Images/09-40-22_232.PNG | 31,378845 | NaN | 25,350300 | 29,388062 | 30,202229 | 30,284812 | 30,244753 | 30,165315 | 1,833973 | 12,005696 | 2,204120 | 1,918011 | 1,837426 | 1,831876 | 1,834566 | 1,839912
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
