Aarhus-University-MPE/Ice-Nucleation-Controller/docs/Calibration Data/Sensor 1,5,6,7,8/Calibration_11/Data.csv

Time [MM:SS] | Image file path | T1 | T2 | T3 | T4 | T5 | T6 | T7 | T8 | V1 | V2 | V3 | V4 | V5 | V6 | V7 | V8
10-15-44_523 | C:\Users\au540322\Documents\Projects\Ice-Nucleation\Builds\Full Build\Data\Calibration_11/Images/10-15-44_523.PNG | 15,740458 | NaN | 26,036130 | 29,588565 | 15,626403 | 15,761409 | 15,688839 | 15,598679 | 3,105719 | 12,006175 | 2,152805 | 1,904807 | 3,115183 | 3,100349 | 3,108315 | 3,118236
10-15-45_022 | C:\Users\au540322\Documents\Projects\Ice-Nucleation\Builds\Full Build\Data\Calibration_11/Images/10-15-45_022.PNG | 15,740452 | NaN | 26,044512 | 29,584451 | 15,626278 | 15,760795 | 15,688866 | 15,598625 | 3,105720 | 12,006155 | 2,152186 | 1,905077 | 3,115196 | 3,100416 | 3,108312 | 3,118242
10-15-45_523 | C:\Users\au540322\Documents\Projects\Ice-Nucleation\Builds\Full Build\Data\Calibration_11/Images/10-15-45_523.PNG | 15,740190 | NaN | 26,051550 | 29,587539 | 15,626034 | 15,761170 | 15,688785 | 15,598847 | 3,105747 | 12,006163 | 2,151665 | 1,904875 | 3,115223 | 3,100375 | 3,108321 | 3,118218
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
