Aarhus-University-MPE/Ice-Nucleation-Controller/docs/Calibration Data/Sensor 1,5,6,7,8/Calibration_12/Data.csv

Time [MM:SS] | Image file path | T1 | T2 | T3 | T4 | T5 | T6 | T7 | T8 | V1 | V2 | V3 | V4 | V5 | V6 | V7 | V8
10-47-21_823 | C:\Users\au540322\Documents\Projects\Ice-Nucleation\Builds\Full Build\Data\Calibration_12/Images/10-47-21_823.PNG | 5,495387 | NaN | 26,212492 | 29,895602 | 5,998843 | 6,164377 | 6,072282 | 5,976543 | 4,309188 | 12,006339 | 2,139799 | 1,884765 | 4,327581 | 4,304223 | 4,317208 | 4,330734
10-47-22_323 | C:\Users\au540322\Documents\Projects\Ice-Nucleation\Builds\Full Build\Data\Calibration_12/Images/10-47-22_323.PNG | 5,495337 | NaN | 26,208359 | 29,899788 | 5,998746 | 6,164157 | 6,072802 | 5,976855 | 4,309194 | 12,006390 | 2,140103 | 1,884493 | 4,327594 | 4,304254 | 4,317134 | 4,330690
10-47-22_823 | C:\Users\au540322\Documents\Projects\Ice-Nucleation\Builds\Full Build\Data\Calibration_12/Images/10-47-22_823.PNG | 5,495495 | NaN | 26,197881 | 29,904535 | 5,998894 | 6,163852 | 6,072891 | 5,976994 | 4,309173 | 12,006335 | 2,140874 | 1,884185 | 4,327573 | 4,304297 | 4,317122 | 4,330670
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
