Aarhus-University-MPE/Ice-Nucleation-Controller/docs/Calibration Data/Sensor 1,5,6,7,8/Calibration_13/Data.csv

Time [MM:SS] | Image file path | T1 | T2 | T3 | T4 | T5 | T6 | T7 | T8 | V1 | V2 | V3 | V4 | V5 | V6 | V7 | V8
11-27-00_655 | C:\Users\au540322\Documents\Projects\Ice-Nucleation\Builds\Full Build\Data\Calibration_13/Images/11-27-00_655.PNG | 0,450249 | NaN | 26,624232 | 30,747617 | 1,208974 | 1,385751 | 1,288222 | 1,191603 | 5,009051 | 12,006434 | 2,109733 | 1,830252 | 5,037481 | 5,010191 | 5,025238 | 5,040167
11-27-01_155 | C:\Users\au540322\Documents\Projects\Ice-Nucleation\Builds\Full Build\Data\Calibration_13/Images/11-27-01_155.PNG | 0,450093 | NaN | 26,634368 | 30,756922 | 1,208673 | 1,385820 | 1,288280 | 1,191271 | 5,009074 | 12,006483 | 2,108998 | 1,829665 | 5,037527 | 5,010180 | 5,025229 | 5,040218
11-27-01_654 | C:\Users\au540322\Documents\Projects\Ice-Nucleation\Builds\Full Build\Data\Calibration_13/Images/11-27-01_654.PNG | 0,450175 | NaN | 26,645396 | 30,769817 | 1,209047 | 1,385681 | 1,288141 | 1,191691 | 5,009062 | 12,006458 | 2,108199 | 1,828853 | 5,037470 | 5,010202 | 5,025250 | 5,040153
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
