Aarhus-University-MPE/Ice-Nucleation-Controller/docs/Calibration Data/Sensor 1,5,6,7,8/Calibration_14/Data.csv

Time [MM:SS] | Image file path | T1 | T2 | T3 | T4 | T5 | T6 | T7 | T8 | V1 | V2 | V3 | V4 | V5 | V6 | V7 | V8
11-59-05_386 | C:\Users\au540322\Documents\Projects\Ice-Nucleation\Builds\Full Build\Data\Calibration_14/Images/11-59-05_386.PNG | 26,160683 | NaN | 27,026659 | 31,279783 | -3,565307 | -3,411248 | -3,482111 | -3,576571 | 2,189312 | 12,006509 | 2,080747 | 1,797015 | 5,800178 | 5,774903 | 5,786524 | 5,802027
11-59-05_886 | C:\Users\au540322\Documents\Projects\Ice-Nucleation\Builds\Full Build\Data\Calibration_14/Images/11-59-05_886.PNG | 26,166770 | NaN | 27,023768 | 31,274986 | -3,564962 | -3,411190 | -3,482031 | -3,576408 | 2,188860 | 12,006535 | 2,080954 | 1,797311 | 5,800121 | 5,774894 | 5,786511 | 5,802001
11-59-06_387 | C:\Users\au540322\Documents\Projects\Ice-Nucleation\Builds\Full Build\Data\Calibration_14/Images/11-59-06_387.PNG | 26,170425 | NaN | 27,021327 | 31,270229 | -3,565350 | -3,411434 | -3,481994 | -3,576735 | 2,188589 | 12,006520 | 2,081128 | 1,797606 | 5,800185 | 5,774933 | 5,786505 | 5,802054
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
