Aarhus-University-MPE/Ice-Nucleation-Controller/docs/Calibration Data/Sensor 1,5,6,7,8/Calibration_15/Data.csv

Time [MM:SS] | Image file path | T1 | T2 | T3 | T4 | T5 | T6 | T7 | T8 | V1 | V2 | V3 | V4 | V5 | V6 | V7 | V8
12-47-09_032 | C:\Users\au540322\Documents\Projects\Ice-Nucleation\Builds\Full Build\Data\Calibration_15/Images/12-47-09_032.PNG | 27,668087 | NaN | 26,885481 | 30,685760 | -8,321600 | -8,169860 | -8,237872 | -8,327755 | 2,080177 | 12,006570 | 2,090871 | 1,834155 | 6,593980 | 6,568391 | 6,579859 | 6,595018
12-47-09_532 | C:\Users\au540322\Documents\Projects\Ice-Nucleation\Builds\Full Build\Data\Calibration_15/Images/12-47-09_532.PNG | 27,667918 | NaN | 26,881808 | 30,691308 | -8,321614 | -8,170033 | -8,237674 | -8,327702 | 2,080189 | 12,006593 | 2,091135 | 1,833805 | 6,593982 | 6,568420 | 6,579826 | 6,595009
12-47-10_033 | C:\Users\au540322\Documents\Projects\Ice-Nucleation\Builds\Full Build\Data\Calibration_15/Images/12-47-10_033.PNG | 27,670645 | NaN | 26,879461 | 30,698594 | -8,321614 | -8,169906 | -8,237723 | -8,327999 | 2,079996 | 12,006540 | 2,091304 | 1,833345 | 6,593982 | 6,568398 | 6,579834 | 6,595059
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
