Aarhus-University-MPE/Ice-Nucleation-Controller/docs/Calibration Data/Sensor 1,5,6,7,8/Calibration_16/Data.csv

Time [MM:SS] | Image file path | T1 | T2 | T3 | T4 | T5 | T6 | T7 | T8 | V1 | V2 | V3 | V4 | V5 | V6 | V7 | V8
13-24-36_407 | C:\Users\au540322\Documents\Projects\Ice-Nucleation\Builds\Full Build\Data\Calibration_16/Images/13-24-36_407.PNG | 35,666787 | NaN | 27,028117 | 31,677461 | -13,059061 | -12,918520 | -12,973926 | -13,056254 | 1,585980 | 12,006511 | 2,080643 | 1,772577 | 7,391846 | 7,368349 | 7,377615 | 7,391377
13-24-36_907 | C:\Users\au540322\Documents\Projects\Ice-Nucleation\Builds\Full Build\Data\Calibration_16/Images/13-24-36_907.PNG | 35,668566 | NaN | 27,027051 | 31,676738 | -13,059129 | -12,918474 | -12,973973 | -13,056229 | 1,585885 | 12,006543 | 2,080719 | 1,772621 | 7,391857 | 7,368342 | 7,377623 | 7,391373
13-24-37_407 | C:\Users\au540322\Documents\Projects\Ice-Nucleation\Builds\Full Build\Data\Calibration_16/Images/13-24-37_407.PNG | 35,669822 | NaN | 27,026976 | 31,677451 | -13,059225 | -12,918467 | -12,973930 | -13,056108 | 1,585817 | 12,006541 | 2,080724 | 1,772578 | 7,391873 | 7,368340 | 7,377615 | 7,391352
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
