Aarhus-University-MPE/Ice-Nucleation-Controller/docs/Calibration Data/Sensor 1,5,6,7,8/Calibration_17/Data.csv

Time [MM:SS] | Image file path | T1 | T2 | T3 | T4 | T5 | T6 | T7 | T8 | V1 | V2 | V3 | V4 | V5 | V6 | V7 | V8
14-00-05_871 | C:\Users\au540322\Documents\Projects\Ice-Nucleation\Builds\Full Build\Data\Calibration_17/Images/14-00-05_871.PNG | 36,538589 | NaN | 27,103737 | 31,741774 | -17,772982 | -17,637528 | -17,685257 | -17,756450 | 1,539949 | 12,006555 | 2,075240 | 1,768657 | 8,163808 | 8,142195 | 8,149815 | 8,161172
14-00-06_382 | C:\Users\au540322\Documents\Projects\Ice-Nucleation\Builds\Full Build\Data\Calibration_17/Images/14-00-06_382.PNG | 36,538073 | NaN | 27,101515 | 31,737584 | -17,772945 | -17,637281 | -17,685418 | -17,756394 | 1,539975 | 12,006544 | 2,075399 | 1,768912 | 8,163802 | 8,142155 | 8,149841 | 8,161163
14-00-06_871 | C:\Users\au540322\Documents\Projects\Ice-Nucleation\Builds\Full Build\Data\Calibration_17/Images/14-00-06_871.PNG | 36,539735 | NaN | 27,101215 | 31,734315 | -17,772851 | -17,637095 | -17,685362 | -17,756543 | 1,539889 | 12,006551 | 2,075420 | 1,769111 | 8,163787 | 8,142125 | 8,149832 | 8,161187
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
