Aarhus-University-MPE/Ice-Nucleation-Controller/docs/Calibration Data/Sensor 1,5,6,7,8/Calibration_18/Data.csv

Time [MM:SS] | Image file path | T1 | T2 | T3 | T4 | T5 | T6 | T7 | T8 | V1 | V2 | V3 | V4 | V5 | V6 | V7 | V8
14-24-17_870 | C:\Users\au540322\Documents\Projects\Ice-Nucleation\Builds\Full Build\Data\Calibration_18/Images/14-24-17_870.PNG | 37,571993 | NaN | 27,059071 | 31,415742 | -22,450877 | -22,321743 | -22,361173 | -22,419425 | 1,487186 | 12,006523 | 2,078430 | 1,788622 | 8,880824 | 8,861898 | 8,867683 | 8,876219
14-24-18_371 | C:\Users\au540322\Documents\Projects\Ice-Nucleation\Builds\Full Build\Data\Calibration_18/Images/14-24-18_371.PNG | 37,573467 | NaN | 27,063659 | 31,426157 | -22,451280 | -22,321710 | -22,361344 | -22,419246 | 1,487112 | 12,006552 | 2,078102 | 1,787980 | 8,880883 | 8,861893 | 8,867708 | 8,876193
14-24-18_871 | C:\Users\au540322\Documents\Projects\Ice-Nucleation\Builds\Full Build\Data\Calibration_18/Images/14-24-18_871.PNG | 37,573027 | NaN | 27,066813 | 31,435463 | -22,451479 | -22,321710 | -22,361421 | -22,419340 | 1,487134 | 12,006551 | 2,077876 | 1,787408 | 8,880912 | 8,861893 | 8,867719 | 8,876207
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
