Aarhus-University-MPE/Ice-Nucleation-Controller/docs/Calibration Data/Sensor 1,5,6,7,8/Calibration_19/Data.csv

Time [MM:SS] | Image file path | T1 | T2 | T3 | T4 | T5 | T6 | T7 | T8 | V1 | V2 | V3 | V4 | V5 | V6 | V7 | V8
17-14-38_234 | C:\Users\au540322\Documents\Projects\Ice-Nucleation\Builds\Full Build\Data\Calibration_19/Images/17-14-38_234.PNG | 23,057686 | NaN | 26,169844 | 26,090352 | -31,556207 | -31,498902 | -31,524167 | -31,577834 | 2,431716 | 12,006046 | 2,142937 | 2,148700 | 10,059481 | 10,053105 | 10,055918 | 10,061884
17-14-38_734 | C:\Users\au540322\Documents\Projects\Ice-Nucleation\Builds\Full Build\Data\Calibration_19/Images/17-14-38_734.PNG | 23,052742 | NaN | 26,177624 | 26,081462 | -31,556019 | -31,498441 | -31,524236 | -31,577818 | 2,432122 | 12,006029 | 2,142365 | 2,149357 | 10,059460 | 10,053054 | 10,055926 | 10,061882
17-14-39_234 | C:\Users\au540322\Documents\Projects\Ice-Nucleation\Builds\Full Build\Data\Calibration_19/Images/17-14-39_234.PNG | 23,072078 | NaN | 26,178636 | 26,076248 | -31,556684 | -31,499282 | -31,524472 | -31,577968 | 2,430535 | 12,006042 | 2,142290 | 2,149743 | 10,059534 | 10,053148 | 10,055952 | 10,061899
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
