Aarhus-University-MPE/Ice-Nucleation-Controller/docs/Calibration Data/Sensor 1,5,6,7,8/Calibration_2/Data.csv

Time [MM:SS] | Image file path | T1 | T2 | T3 | T4 | T5 | T6 | T7 | T8 | V1 | V2 | V3 | V4 | V5 | V6 | V7 | V8
09-55-36_129 | C:\Users\au540322\Documents\Projects\Ice-Nucleation\Builds\Full Build\Data\Calibration_2/Images/09-55-36_129.PNG | 5,468521 | NaN | 26,380065 | 26,345844 | 6,007838 | 6,171376 | 6,082466 | 5,978697 | 4,312740 | 12,006359 | 2,127512 | 2,129890 | 4,326309 | 4,303237 | 4,315771 | 4,330429
09-55-36_629 | C:\Users\au540322\Documents\Projects\Ice-Nucleation\Builds\Full Build\Data\Calibration_2/Images/09-55-36_629.PNG | 5,468584 | NaN | 26,382054 | 26,329034 | 6,007518 | 6,171000 | 6,082559 | 5,978553 | 4,312731 | 12,006348 | 2,127367 | 2,131122 | 4,326355 | 4,303290 | 4,315757 | 4,330449
09-55-37_128 | C:\Users\au540322\Documents\Projects\Ice-Nucleation\Builds\Full Build\Data\Calibration_2/Images/09-55-37_128.PNG | 5,468728 | NaN | 26,381557 | 26,310536 | 6,007674 | 6,171478 | 6,082660 | 5,978587 | 4,312712 | 12,006320 | 2,127403 | 2,132480 | 4,326332 | 4,303223 | 4,315743 | 4,330445
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
