Aarhus-University-MPE/Ice-Nucleation-Controller/docs/Calibration Data/Sensor 1,5,6,7,8/Calibration_20/Data.csv

Time [MM:SS] | Image file path | T1 | T2 | T3 | T4 | T5 | T6 | T7 | T8 | V1 | V2 | V3 | V4 | V5 | V6 | V7 | V8
14-21-08_734 | C:\Users\au540322\Documents\Projects\Ice-Nucleation\Builds\Full Build\Data\Calibration_20/Images/14-21-08_734.PNG | 33,151503 | NaN | 26,110860 | 27,352189 | -27,078828 | -26,955425 | -26,988374 | -27,031851 | 1,726951 | 12,006058 | 2,147285 | 2,057358 | 9,520311 | 9,504300 | 9,508581 | 9,514223
14-21-09_234 | C:\Users\au540322\Documents\Projects\Ice-Nucleation\Builds\Full Build\Data\Calibration_20/Images/14-21-09_234.PNG | 33,168930 | NaN | 26,104236 | 27,335950 | -27,078994 | -26,955292 | -26,988094 | -27,032141 | 1,725931 | 12,006061 | 2,147774 | 2,058509 | 9,520333 | 9,504283 | 9,508545 | 9,514261
14-21-09_735 | C:\Users\au540322\Documents\Projects\Ice-Nucleation\Builds\Full Build\Data\Calibration_20/Images/14-21-09_735.PNG | 33,182707 | NaN | 26,089516 | 27,327904 | -27,078985 | -26,955388 | -26,988318 | -27,031929 | 1,725125 | 12,006093 | 2,148860 | 2,059079 | 9,520332 | 9,504296 | 9,508574 | 9,514233
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
