Aarhus-University-MPE/Ice-Nucleation-Controller/docs/Calibration Data/Sensor 1,5,6,7,8/Calibration_21/Data.csv

Time [MM:SS] | Image file path | T1 | T2 | T3 | T4 | T5 | T6 | T7 | T8 | V1 | V2 | V3 | V4 | V5 | V6 | V7 | V8
15-07-07_033 | C:\Users\au540322\Documents\Projects\Ice-Nucleation\Builds\Full Build\Data\Calibration_21/Images/15-07-07_033.PNG | 34,151252 | NaN | 26,167197 | 26,073638 | -22,445314 | -22,320378 | -22,359698 | -22,421521 | 1,669432 | 12,006128 | 2,143132 | 2,149936 | 8,880010 | 8,861698 | 8,867466 | 8,876526
15-07-07_533 | C:\Users\au540322\Documents\Projects\Ice-Nucleation\Builds\Full Build\Data\Calibration_21/Images/15-07-07_533.PNG | 34,141481 | NaN | 26,170216 | 26,081139 | -22,445395 | -22,320086 | -22,359950 | -22,421664 | 1,669985 | 12,006171 | 2,142910 | 2,149381 | 8,880022 | 8,861655 | 8,867503 | 8,876547
15-07-08_033 | C:\Users\au540322\Documents\Projects\Ice-Nucleation\Builds\Full Build\Data\Calibration_21/Images/15-07-08_033.PNG | 34,132092 | NaN | 26,170257 | 26,090610 | -22,445468 | -22,319866 | -22,359872 | -22,421208 | 1,670516 | 12,006180 | 2,142907 | 2,148681 | 8,880032 | 8,861623 | 8,867492 | 8,876480
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
