Aarhus-University-MPE/Ice-Nucleation-Controller/docs/Calibration Data/Sensor 1,5,6,7,8/Calibration_22/Data.csv

Time [MM:SS] | Image file path | T1 | T2 | T3 | T4 | T5 | T6 | T7 | T8 | V1 | V2 | V3 | V4 | V5 | V6 | V7 | V8
15-33-01_070 | C:\Users\au540322\Documents\Projects\Ice-Nucleation\Builds\Full Build\Data\Calibration_22/Images/15-33-01_070.PNG | 34,292724 | NaN | 26,569607 | 26,386795 | -17,759721 | -17,634382 | -17,679036 | -17,758977 | 1,661453 | 12,006108 | 2,113698 | 2,126890 | 8,161694 | 8,141692 | 8,148822 | 8,161575
15-33-01_569 | C:\Users\au540322\Documents\Projects\Ice-Nucleation\Builds\Full Build\Data\Calibration_22/Images/15-33-01_569.PNG | 34,476092 | NaN | 26,562791 | 26,369620 | -17,760136 | -17,634721 | -17,679084 | -17,759070 | 1,651170 | 12,006149 | 2,114193 | 2,128148 | 8,161760 | 8,141746 | 8,148830 | 8,161590
15-33-02_069 | C:\Users\au540322\Documents\Projects\Ice-Nucleation\Builds\Full Build\Data\Calibration_22/Images/15-33-02_069.PNG | 34,478928 | NaN | 26,548752 | 26,350666 | -17,760124 | -17,634829 | -17,679151 | -17,758831 | 1,651012 | 12,006155 | 2,115213 | 2,129536 | 8,161758 | 8,141764 | 8,148841 | 8,161552
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
