Aarhus-University-MPE/Ice-Nucleation-Controller/docs/Calibration Data/Sensor 1,5,6,7,8/Calibration_23/Data.csv

Time [MM:SS] | Image file path | T1 | T2 | T3 | T4 | T5 | T6 | T7 | T8 | V1 | V2 | V3 | V4 | V5 | V6 | V7 | V8
16-33-27_711 | C:\Users\au540322\Documents\Projects\Ice-Nucleation\Builds\Full Build\Data\Calibration_23/Images/16-33-27_711.PNG | 23,547435 | NaN | 25,694747 | 25,481305 | -12,994921 | -12,895999 | -12,953683 | -13,059938 | 2,391820 | 12,006064 | 2,178201 | 2,194196 | 7,381125 | 7,364582 | 7,374230 | 7,391993
16-33-28_210 | C:\Users\au540322\Documents\Projects\Ice-Nucleation\Builds\Full Build\Data\Calibration_23/Images/16-33-28_210.PNG | 23,504647 | NaN | 25,701918 | 25,484583 | -12,994807 | -12,896160 | -12,953697 | -13,059970 | 2,395281 | 12,006052 | 2,177665 | 2,193948 | 7,381106 | 7,364609 | 7,374232 | 7,391998
16-33-28_710 | C:\Users\au540322\Documents\Projects\Ice-Nucleation\Builds\Full Build\Data\Calibration_23/Images/16-33-28_710.PNG | 23,473908 | NaN | 25,704508 | 25,490168 | -12,995010 | -12,896149 | -12,953391 | -13,059795 | 2,397770 | 12,006039 | 2,177471 | 2,193527 | 7,381140 | 7,364607 | 7,374181 | 7,391969
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
