Aarhus-University-MPE/Ice-Nucleation-Controller/docs/Calibration Data/Sensor 1,5,6,7,8/Calibration_24/Data.csv

Time [MM:SS] | Image file path | T1 | T2 | T3 | T4 | T5 | T6 | T7 | T8 | V1 | V2 | V3 | V4 | V5 | V6 | V7 | V8
17-45-01_324 | C:\Users\au540322\Documents\Projects\Ice-Nucleation\Builds\Full Build\Data\Calibration_24/Images/17-45-01_324.PNG | 23,753953 | NaN | 27,203103 | 26,711480 | -26,981691 | -26,931401 | -26,963180 | -27,035928 | 2,375184 | 12,006034 | 2,068162 | 2,103251 | 9,507713 | 9,501176 | 9,505308 | 9,514752
17-45-01_824 | C:\Users\au540322\Documents\Projects\Ice-Nucleation\Builds\Full Build\Data\Calibration_24/Images/17-45-01_824.PNG | 23,742500 | NaN | 27,218681 | 26,738237 | -26,981283 | -26,931135 | -26,963345 | -27,035556 | 2,376104 | 12,006007 | 2,067055 | 2,101314 | 9,507660 | 9,501142 | 9,505330 | 9,514704
17-45-02_324 | C:\Users\au540322\Documents\Projects\Ice-Nucleation\Builds\Full Build\Data\Calibration_24/Images/17-45-02_324.PNG | 23,776953 | NaN | 27,223486 | 26,751612 | -26,981521 | -26,931149 | -26,963056 | -27,035533 | 2,373338 | 12,006064 | 2,066713 | 2,100347 | 9,507691 | 9,501144 | 9,505292 | 9,514701
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
