Aarhus-University-MPE/Ice-Nucleation-Controller/docs/Calibration Data/Sensor 1,5,6,7,8/Calibration_25/Data.csv

Time [MM:SS] | Image file path | T1 | T2 | T3 | T4 | T5 | T6 | T7 | T8 | V1 | V2 | V3 | V4 | V5 | V6 | V7 | V8
18-19-10_196 | C:\Users\au540322\Documents\Projects\Ice-Nucleation\Builds\Full Build\Data\Calibration_25/Images/18-19-10_196.PNG | 27,318661 | NaN | 26,617994 | 26,223969 | -8,200829 | -8,146603 | -8,197814 | -8,331286 | 2,104989 | 12,005921 | 2,110185 | 2,138842 | 6,573612 | 6,564469 | 6,573104 | 6,595614
18-19-10_696 | C:\Users\au540322\Documents\Projects\Ice-Nucleation\Builds\Full Build\Data\Calibration_25/Images/18-19-10_696.PNG | 27,346813 | NaN | 26,596825 | 26,216520 | -8,201115 | -8,146214 | -8,197694 | -8,331473 | 2,102980 | 12,006003 | 2,111721 | 2,139391 | 6,573661 | 6,564404 | 6,573084 | 6,595645
18-19-11_196 | C:\Users\au540322\Documents\Projects\Ice-Nucleation\Builds\Full Build\Data\Calibration_25/Images/18-19-11_196.PNG | 27,353622 | NaN | 26,573570 | 26,206653 | -8,200843 | -8,146755 | -8,197930 | -8,331236 | 2,102494 | 12,005943 | 2,113410 | 2,140117 | 6,573615 | 6,564495 | 6,573124 | 6,595605
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
