Aarhus-University-MPE/Ice-Nucleation-Controller/docs/Calibration Data/Sensor 1,5,6,7,8/Calibration_26/Data.csv

Time [MM:SS] | Image file path | T1 | T2 | T3 | T4 | T5 | T6 | T7 | T8 | V1 | V2 | V3 | V4 | V5 | V6 | V7 | V8
18-46-53_353 | C:\Users\au540322\Documents\Projects\Ice-Nucleation\Builds\Full Build\Data\Calibration_26/Images/18-46-53_353.PNG | 29,992760 | NaN | 26,610336 | 26,434072 | -3,468394 | -3,380325 | -3,410645 | -3,581436 | 1,922324 | 12,005945 | 2,110741 | 2,123432 | 5,784274 | 5,769834 | 5,774804 | 5,802826
18-46-53_853 | C:\Users\au540322\Documents\Projects\Ice-Nucleation\Builds\Full Build\Data\Calibration_26/Images/18-46-53_853.PNG | 29,771901 | NaN | 26,613015 | 26,435793 | -3,468140 | -3,380682 | -3,410837 | -3,581080 | 1,936793 | 12,005881 | 2,110546 | 2,123306 | 5,784232 | 5,769893 | 5,774836 | 5,802768
18-46-54_361 | C:\Users\au540322\Documents\Projects\Ice-Nucleation\Builds\Full Build\Data\Calibration_26/Images/18-46-54_361.PNG | 29,999683 | NaN | 26,626649 | 26,436747 | -3,468568 | -3,380976 | -3,410230 | -3,581189 | 1,921873 | 12,005932 | 2,109558 | 2,123236 | 5,784303 | 5,769941 | 5,774736 | 5,802786
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
