Aarhus-University-MPE/Ice-Nucleation-Controller/docs/Calibration Data/Sensor 1,5,6,7,8/Calibration_27/Data.csv

Time [MM:SS] | Image file path | T1 | T2 | T3 | T4 | T5 | T6 | T7 | T8 | V1 | V2 | V3 | V4 | V5 | V6 | V7 | V8
12-36-27_907 | C:\Users\au540322\Documents\Projects\Ice-Nucleation\Builds\Full Build\Data\Calibration_27/Images/12-36-27_907.PNG | 8,029403 | NaN | 24,918348 | 24,851851 | -31,627109 | -31,473719 | -31,439312 | -31,566806 | 3,983202 | 12,004959 | 2,237047 | 2,242198 | 10,067351 | 10,050299 | 10,046461 | 10,060659
12-36-28_407 | C:\Users\au540322\Documents\Projects\Ice-Nucleation\Builds\Full Build\Data\Calibration_27/Images/12-36-28_407.PNG | 7,971586 | NaN | 24,920747 | 24,847489 | -31,626770 | -31,473923 | -31,439248 | -31,566479 | 3,990437 | 12,004953 | 2,236863 | 2,242534 | 10,067313 | 10,050322 | 10,046453 | 10,060623
12-36-28_907 | C:\Users\au540322\Documents\Projects\Ice-Nucleation\Builds\Full Build\Data\Calibration_27/Images/12-36-28_907.PNG | 7,894005 | NaN | 24,919870 | 24,846012 | -31,627201 | -31,474179 | -31,439328 | -31,566420 | 4,000161 | 12,004994 | 2,236930 | 2,242648 | 10,067361 | 10,050350 | 10,046462 | 10,060616
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
