Aarhus-University-MPE/Ice-Nucleation-Controller/docs/Calibration Data/Sensor 1,5,6,7,8/Calibration_28/Data.csv

Time [MM:SS] | Image file path | T1 | T2 | T3 | T4 | T5 | T6 | T7 | T8 | V1 | V2 | V3 | V4 | V5 | V6 | V7 | V8
13-16-58_152 | C:\Users\au540322\Documents\Projects\Ice-Nucleation\Builds\Full Build\Data\Calibration_28/Images/13-16-58_152.PNG | 29,333570 | NaN | 25,170751 | 25,172859 | 12,669796 | 1,411062 | 1,400921 | 1,218432 | 1,965832 | 12,005337 | 2,217749 | 2,217592 | 3,455146 | 5,006290 | 5,007853 | 5,036019
13-16-58_651 | C:\Users\au540322\Documents\Projects\Ice-Nucleation\Builds\Full Build\Data\Calibration_28/Images/13-16-58_651.PNG | 29,325900 | NaN | 25,174838 | 25,176791 | 12,675022 | 1,410880 | 1,400712 | 1,218081 | 1,966344 | 12,005220 | 2,217438 | 2,217292 | 3,454520 | 5,006318 | 5,007885 | 5,036073
13-16-59_151 | C:\Users\au540322\Documents\Projects\Ice-Nucleation\Builds\Full Build\Data\Calibration_28/Images/13-16-59_151.PNG | 29,330900 | NaN | 25,173938 | 25,198973 | 12,678299 | 1,411433 | 1,400546 | 1,218158 | 1,966010 | 12,005302 | 2,217507 | 2,215602 | 3,454127 | 5,006233 | 5,007910 | 5,036061
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
