Aarhus-University-MPE/Ice-Nucleation-Controller/docs/Calibration Data/Sensor 1,5,6,7,8/Calibration_29/Data.csv

Time [MM:SS] | Image file path | T1 | T2 | T3 | T4 | T5 | T6 | T7 | T8 | V1 | V2 | V3 | V4 | V5 | V6 | V7 | V8
13-44-36_869 | C:\Users\au540322\Documents\Projects\Ice-Nucleation\Builds\Full Build\Data\Calibration_29/Images/13-44-36_869.PNG | 31,941422 | NaN | 25,143246 | 25,042299 | 26,764273 | 6,330814 | 6,179617 | 6,087307 | 1,799296 | 12,005355 | 2,219845 | 2,227568 | 2,083861 | 4,280821 | 4,302076 | 4,315087
13-44-37_370 | C:\Users\au540322\Documents\Projects\Ice-Nucleation\Builds\Full Build\Data\Calibration_29/Images/13-44-37_370.PNG | 31,931338 | NaN | 25,140446 | 25,053144 | 26,766745 | 6,330950 | 6,180168 | 6,087387 | 1,799911 | 12,005344 | 2,220058 | 2,226738 | 2,083673 | 4,280802 | 4,301999 | 4,315076
13-44-37_869 | C:\Users\au540322\Documents\Projects\Ice-Nucleation\Builds\Full Build\Data\Calibration_29/Images/13-44-37_869.PNG | 31,902226 | NaN | 25,145053 | 25,066259 | 26,768294 | 6,330857 | 6,180130 | 6,087958 | 1,801690 | 12,005307 | 2,219707 | 2,225734 | 2,083555 | 4,280815 | 4,302004 | 4,314996
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
