Aarhus-University-MPE/Ice-Nucleation-Controller/docs/Calibration Data/Sensor 1,5,6,7,8/Calibration_3/Data.csv

Time [MM:SS] | Image file path | T1 | T2 | T3 | T4 | T5 | T6 | T7 | T8 | V1 | V2 | V3 | V4 | V5 | V6 | V7 | V8
10-29-20_279 | C:\Users\au540322\Documents\Projects\Ice-Nucleation\Builds\Full Build\Data\Calibration_3/Images/10-29-20_279.PNG | 0,373250 | NaN | 26,530786 | 27,004761 | 1,217646 | 1,393457 | 1,296572 | 1,190755 | 5,020212 | 12,006406 | 2,116520 | 2,082120 | 5,036140 | 5,009003 | 5,023948 | 5,040298
10-29-20_778 | C:\Users\au540322\Documents\Projects\Ice-Nucleation\Builds\Full Build\Data\Calibration_3/Images/10-29-20_778.PNG | 0,373102 | NaN | 26,531663 | 27,005659 | 1,217838 | 1,393658 | 1,296449 | 1,191063 | 5,020234 | 12,006376 | 2,116456 | 2,082055 | 5,036111 | 5,008972 | 5,023967 | 5,040250
10-29-21_278 | C:\Users\au540322\Documents\Projects\Ice-Nucleation\Builds\Full Build\Data\Calibration_3/Images/10-29-21_278.PNG | 0,373181 | NaN | 26,530638 | 27,010731 | 1,217661 | 1,393469 | 1,296561 | 1,190832 | 5,020222 | 12,006446 | 2,116531 | 2,081692 | 5,036138 | 5,009001 | 5,023950 | 5,040286
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
