Aarhus-University-MPE/Ice-Nucleation-Controller/docs/Calibration Data/Sensor 1,5,6,7,8/Calibration_30/Data.csv

Time [MM:SS] | Image file path | T1 | T2 | T3 | T4 | T5 | T6 | T7 | T8 | V1 | V2 | V3 | V4 | V5 | V6 | V7 | V8
14-40-52_340 | C:\Users\au540322\Documents\Projects\Ice-Nucleation\Builds\Full Build\Data\Calibration_30/Images/14-40-52_340.PNG | 37,192587 | NaN | 24,871059 | 24,594246 | 44,437459 | 36,644027 | 15,790568 | 46,083036 | 1,506334 | 12,005215 | 2,240681 | 2,262135 | 1,095036 | 1,451777 | 3,097153 | 1,032429
14-40-52_840 | C:\Users\au540322\Documents\Projects\Ice-Nucleation\Builds\Full Build\Data\Calibration_30/Images/14-40-52_840.PNG | 37,189079 | NaN | 24,865238 | 24,581196 | 44,396810 | 36,727502 | 15,789746 | 46,082324 | 1,506512 | 12,005226 | 2,241128 | 2,263149 | 1,096633 | 1,447366 | 3,097243 | 1,032455
14-40-53_340 | C:\Users\au540322\Documents\Projects\Ice-Nucleation\Builds\Full Build\Data\Calibration_30/Images/14-40-53_340.PNG | 37,183872 | NaN | 24,862100 | 24,567792 | 44,360491 | 36,735921 | 15,789774 | 46,086643 | 1,506777 | 12,005282 | 2,241370 | 2,264192 | 1,098062 | 1,446922 | 3,097240 | 1,032296
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
