Aarhus-University-MPE/Ice-Nucleation-Controller/docs/Calibration Data/Sensor 1,5,6,7,8/Calibration_31/Data.csv

Time [MM:SS] | Image file path | T1 | T2 | T3 | T4 | T5 | T6 | T7 | T8 | V1 | V2 | V3 | V4 | V5 | V6 | V7 | V8
15-31-52_500 | C:\Users\au540322\Documents\Projects\Ice-Nucleation\Builds\Full Build\Data\Calibration_31/Images/15-31-52_500.PNG | 54,361045 | NaN | 24,625493 | 24,608444 | 54,846696 | 72,279250 | 30,316160 | 58,648722 | 0,854273 | 12,005220 | 2,259641 | 2,261031 | 0,758429 | 0,423394 | 1,829774 | 0,665443
15-31-53_000 | C:\Users\au540322\Documents\Projects\Ice-Nucleation\Builds\Full Build\Data\Calibration_31/Images/15-31-53_000.PNG | 54,369983 | NaN | 24,626531 | 24,619709 | 54,849009 | 72,281744 | 30,317894 | 58,648958 | 0,854028 | 12,005215 | 2,259560 | 2,260156 | 0,758368 | 0,423360 | 1,829658 | 0,665438
15-31-53_500 | C:\Users\au540322\Documents\Projects\Ice-Nucleation\Builds\Full Build\Data\Calibration_31/Images/15-31-53_500.PNG | 54,364971 | NaN | 24,629699 | 24,629551 | 54,846355 | 72,283232 | 30,317538 | 58,647410 | 0,854166 | 12,005219 | 2,259315 | 2,259392 | 0,758438 | 0,423340 | 1,829682 | 0,665473
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
