Aarhus-University-MPE/Ice-Nucleation-Controller/docs/Calibration Data/Sensor 1,5,6,7,8/Calibration_32/Data.csv

Time [MM:SS] | Image file path | T1 | T2 | T3 | T4 | T5 | T6 | T7 | T8 | V1 | V2 | V3 | V4 | V5 | V6 | V7 | V8
16-18-41_027 | C:\Users\au540322\Documents\Projects\Ice-Nucleation\Builds\Full Build\Data\Calibration_32/Images/16-18-41_027.PNG | 38,745185 | NaN | 24,935945 | 24,556990 | 41,968523 | 67,804078 | -27,111182 | 50,751735 | 1,429579 | 12,005157 | 2,235696 | 2,265032 | 1,196741 | 0,489690 | 9,524499 | 0,875001
16-18-41_527 | C:\Users\au540322\Documents\Projects\Ice-Nucleation\Builds\Full Build\Data\Calibration_32/Images/16-18-41_527.PNG | 38,693868 | NaN | 24,936427 | 24,576513 | 41,965500 | 67,801891 | -27,125896 | 50,752375 | 1,432049 | 12,005163 | 2,235659 | 2,263513 | 1,196871 | 0,489725 | 9,526402 | 0,874981
16-18-42_027 | C:\Users\au540322\Documents\Projects\Ice-Nucleation\Builds\Full Build\Data\Calibration_32/Images/16-18-42_027.PNG | 38,427484 | NaN | 24,940342 | 24,583212 | 41,967157 | 67,800445 | -27,113044 | 50,751949 | 1,444943 | 12,005167 | 2,235359 | 2,262992 | 1,196800 | 0,489749 | 9,524740 | 0,874994
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
