Aarhus-University-MPE/Ice-Nucleation-Controller/docs/Calibration Data/Sensor 1,5,6,7,8/Calibration_4/Data.csv

Time [MM:SS] | Image file path | T1 | T2 | T3 | T4 | T5 | T6 | T7 | T8 | V1 | V2 | V3 | V4 | V5 | V6 | V7 | V8
11-18-25_361 | C:\Users\au540322\Documents\Projects\Ice-Nucleation\Builds\Full Build\Data\Calibration_4/Images/11-18-25_361.PNG | -4,696930 | NaN | 26,721660 | 27,054520 | -3,556717 | -3,374459 | -3,474433 | -3,579962 | 5,781269 | 12,006584 | 2,102679 | 2,078555 | 5,798768 | 5,768873 | 5,785265 | 5,802584
11-18-25_861 | C:\Users\au540322\Documents\Projects\Ice-Nucleation\Builds\Full Build\Data\Calibration_4/Images/11-18-25_861.PNG | -4,697015 | NaN | 26,719969 | 27,023082 | -3,556462 | -3,374623 | -3,474637 | -3,579962 | 5,781283 | 12,006558 | 2,102801 | 2,080807 | 5,798726 | 5,768900 | 5,785298 | 5,802584
11-18-26_362 | C:\Users\au540322\Documents\Projects\Ice-Nucleation\Builds\Full Build\Data\Calibration_4/Images/11-18-26_362.PNG | -4,697011 | NaN | 26,715492 | 26,997920 | -3,556593 | -3,374499 | -3,474760 | -3,580129 | 5,781282 | 12,006528 | 2,103125 | 2,082610 | 5,798747 | 5,768879 | 5,785318 | 5,802611
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
