Aarhus-University-MPE/Ice-Nucleation-Controller/docs/Calibration Data/Sensor 1,5,6,7,8/Calibration_5/Data.csv

Time [MM:SS] | Image file path | T1 | T2 | T3 | T4 | T5 | T6 | T7 | T8 | V1 | V2 | V3 | V4 | V5 | V6 | V7 | V8
12-10-21_817 | C:\Users\au540322\Documents\Projects\Ice-Nucleation\Builds\Full Build\Data\Calibration_5/Images/12-10-21_817.PNG | -9,741941 | NaN | 27,173212 | 29,058647 | -8,315472 | -8,131716 | -8,231050 | -8,333279 | 6,574890 | 12,006664 | 2,070289 | 1,939903 | 6,592946 | 6,561959 | 6,578709 | 6,595950
12-10-22_319 | C:\Users\au540322\Documents\Projects\Ice-Nucleation\Builds\Full Build\Data\Calibration_5/Images/12-10-22_319.PNG | -9,741720 | NaN | 27,173840 | 29,058121 | -8,315231 | -8,131712 | -8,230629 | -8,333198 | 6,574855 | 12,006660 | 2,070244 | 1,939938 | 6,592906 | 6,561959 | 6,578638 | 6,595936
12-10-22_818 | C:\Users\au540322\Documents\Projects\Ice-Nucleation\Builds\Full Build\Data\Calibration_5/Images/12-10-22_818.PNG | -9,741990 | NaN | 27,175306 | 29,060110 | -8,315362 | -8,131917 | -8,230559 | -8,333477 | 6,574898 | 12,006622 | 2,070140 | 1,939805 | 6,592928 | 6,561993 | 6,578626 | 6,595983
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
