Aarhus-University-MPE/Ice-Nucleation-Controller/docs/Calibration Data/Sensor 1,5,6,7,8/Calibration_6/Data.csv

Time [MM:SS] | Image file path | T1 | T2 | T3 | T4 | T5 | T6 | T7 | T8 | V1 | V2 | V3 | V4 | V5 | V6 | V7 | V8
12-44-02_818 | C:\Users\au540322\Documents\Projects\Ice-Nucleation\Builds\Full Build\Data\Calibration_6/Images/12-44-02_818.PNG | -14,757994 | NaN | 26,816579 | 30,170840 | -13,053636 | -12,876545 | -12,968672 | -13,064482 | 7,373697 | 12,006627 | 2,095829 | 1,866978 | 7,390939 | 7,361328 | 7,376736 | 7,392752
12-44-03_318 | C:\Users\au540322\Documents\Projects\Ice-Nucleation\Builds\Full Build\Data\Calibration_6/Images/12-44-03_318.PNG | -14,758095 | NaN | 26,819392 | 30,180072 | -13,053465 | -12,876763 | -12,968533 | -13,064254 | 7,373713 | 12,006669 | 2,095627 | 1,866384 | 7,390911 | 7,361364 | 7,376713 | 7,392714
12-44-03_818 | C:\Users\au540322\Documents\Projects\Ice-Nucleation\Builds\Full Build\Data\Calibration_6/Images/12-44-03_818.PNG | -14,757971 | NaN | 26,822296 | 30,189409 | -13,053468 | -12,876552 | -12,968868 | -13,064536 | 7,373693 | 12,006670 | 2,095418 | 1,865784 | 7,390911 | 7,361329 | 7,376769 | 7,392761
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
