Aarhus-University-MPE/Ice-Nucleation-Controller/docs/Calibration Data/Sensor 1,5,6,7,8/Calibration_7/Data.csv

Time [MM:SS] | Image file path | T1 | T2 | T3 | T4 | T5 | T6 | T7 | T8 | V1 | V2 | V3 | V4 | V5 | V6 | V7 | V8
13-35-38_588 | C:\Users\au540322\Documents\Projects\Ice-Nucleation\Builds\Full Build\Data\Calibration_7/Images/13-35-38_588.PNG | -19,738801 | NaN | 27,134762 | 30,696575 | -17,765930 | -17,601594 | -17,681919 | -17,768477 | 8,147417 | 12,006733 | 2,073028 | 1,833472 | 8,162684 | 8,136454 | 8,149282 | 8,163090
13-35-39_088 | C:\Users\au540322\Documents\Projects\Ice-Nucleation\Builds\Full Build\Data\Calibration_7/Images/13-35-39_088.PNG | -19,738687 | NaN | 27,134988 | 30,682401 | -17,765871 | -17,601549 | -17,681515 | -17,768245 | 8,147400 | 12,006710 | 2,073012 | 1,834368 | 8,162674 | 8,136447 | 8,149218 | 8,163053
13-35-39_587 | C:\Users\au540322\Documents\Projects\Ice-Nucleation\Builds\Full Build\Data\Calibration_7/Images/13-35-39_587.PNG | -19,738450 | NaN | 27,135038 | 30,666170 | -17,765953 | -17,601556 | -17,682102 | -17,768432 | 8,147364 | 12,006685 | 2,073008 | 1,835393 | 8,162687 | 8,136448 | 8,149311 | 8,163082
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
