Aarhus-University-MPE/Ice-Nucleation-Controller/docs/Calibration Data/Sensor 1,5,6,7,8/Calibration_8/Data.csv

Time [MM:SS] | Image file path | T1 | T2 | T3 | T4 | T5 | T6 | T7 | T8 | V1 | V2 | V3 | V4 | V5 | V6 | V7 | V8
14-27-39_166 | C:\Users\au540322\Documents\Projects\Ice-Nucleation\Builds\Full Build\Data\Calibration_8/Images/14-27-39_166.PNG | -24,672761 | NaN | 27,702053 | 31,431609 | -22,443672 | -22,293531 | -22,359393 | -22,433257 | 8,866982 | 12,006778 | 2,032979 | 1,787645 | 8,879769 | 8,857756 | 8,867422 | 8,878245
14-27-39_666 | C:\Users\au540322\Documents\Projects\Ice-Nucleation\Builds\Full Build\Data\Calibration_8/Images/14-27-39_666.PNG | -24,672538 | NaN | 27,699129 | 31,438321 | -22,443465 | -22,293880 | -22,359429 | -22,433648 | 8,866951 | 12,006788 | 2,033184 | 1,787232 | 8,879739 | 8,857807 | 8,867427 | 8,878302
14-27-40_166 | C:\Users\au540322\Documents\Projects\Ice-Nucleation\Builds\Full Build\Data\Calibration_8/Images/14-27-40_166.PNG | -24,672359 | NaN | 27,698584 | 31,440684 | -22,443102 | -22,293774 | -22,359629 | -22,433534 | 8,866926 | 12,006769 | 2,033222 | 1,787086 | 8,879686 | 8,857792 | 8,867456 | 8,878285
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
