Aarhus-University-MPE/Ice-Nucleation-Controller/docs/Calibration Data/Sensor 1,5,6,7,8/Calibration_9/Data.csv

Time [MM:SS] | Image file path | T1 | T2 | T3 | T4 | T5 | T6 | T7 | T8 | V1 | V2 | V3 | V4 | V5 | V6 | V7 | V8
15-05-18_015 | C:\Users\au540322\Documents\Projects\Ice-Nucleation\Builds\Full Build\Data\Calibration_9/Images/15-05-18_015.PNG | -29,544420 | NaN | 27,725216 | 31,507505 | -27,071198 | -26,939137 | -26,987951 | -27,048203 | 9,509308 | 12,006711 | 2,031360 | 1,782979 | 9,519323 | 9,502183 | 9,508526 | 9,516343
15-05-18_515 | C:\Users\au540322\Documents\Projects\Ice-Nucleation\Builds\Full Build\Data\Calibration_9/Images/15-05-18_515.PNG | -29,544892 | NaN | 27,726496 | 31,489412 | -27,071083 | -26,940040 | -26,987882 | -27,048373 | 9,509367 | 12,006720 | 2,031271 | 1,784091 | 9,519308 | 9,502300 | 9,508517 | 9,516365
15-05-19_015 | C:\Users\au540322\Documents\Projects\Ice-Nucleation\Builds\Full Build\Data\Calibration_9/Images/15-05-19_015.PNG | -29,544550 | NaN | 27,727358 | 31,479613 | -27,071221 | -26,939444 | -26,988213 | -27,048732 | 9,509324 | 12,006720 | 2,031211 | 1,784693 | 9,519326 | 9,502223 | 9,508560 | 9,516412
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
