Aarhus-University-MPE/Ice-Nucleation-Controller/docs/Calibration Data/Sensor 2,3,4/Calibration_0/Data.csv

Time [MM:SS] | Image file path | T1 | T2 | T3 | T4 | T5 | T6 | T7 | T8 | V1 | V2 | V3 | V4 | V5 | V6 | V7 | V8
09-17-44_463 | C:\Users\au540322\Documents\Projects\Ice-Nucleation\Builds\Full Build\Data\Calibration_0/Images/09-17-44_463.PNG | 5,961817 | 5,922297 | 5,988231 | 5,943798 | 26,007102 | 25,939552 | 26,011923 | NaN | 4,332384 | 4,337976 | 4,328648 | 4,334933 | 2,142124 | 2,147417 | 2,141747 | 12,003160
09-17-44_962 | C:\Users\au540322\Documents\Projects\Ice-Nucleation\Builds\Full Build\Data\Calibration_0/Images/09-17-44_962.PNG | 5,961741 | 5,922360 | 5,987746 | 5,944321 | 26,007422 | 25,939545 | 26,010796 | NaN | 4,332394 | 4,337967 | 4,328717 | 4,334859 | 2,142099 | 2,147418 | 2,141835 | 12,003226
09-17-45_463 | C:\Users\au540322\Documents\Projects\Ice-Nucleation\Builds\Full Build\Data\Calibration_0/Images/09-17-45_463.PNG | 5,961665 | 5,922107 | 5,987768 | 5,944329 | 26,006127 | 25,939051 | 26,010027 | NaN | 4,332405 | 4,338003 | 4,328714 | 4,334858 | 2,142201 | 2,147457 | 2,141895 | 12,003183
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
