Aarhus-University-MPE/Ice-Nucleation-Controller/docs/Calibration Data/Sensor 2,3,4/Calibration_15/Data.csv

Time [MM:SS] | Image file path | T1 | T2 | T3 | T4 | T5 | T6 | T7 | T8 | V1 | V2 | V3 | V4 | V5 | V6 | V7 | V8
14-25-59_880 | C:\Users\au540322\Documents\Projects\Ice-Nucleation\Builds\Full Build\Data\Calibration_15/Images/14-25-59_880.PNG | -19,803037 | -19,808691 | -19,838478 | -19,871831 | 24,394057 | 25,311656 | 24,444671 | -115,558893 | 8,157142 | 8,163302 | 8,153856 | 8,169123 | 2,272232 | 2,197443 | 2,268044 | 12,003645
14-26-00_379 | C:\Users\au540322\Documents\Projects\Ice-Nucleation\Builds\Full Build\Data\Calibration_15/Images/14-26-00_379.PNG | -19,803238 | -19,808888 | -19,838332 | -19,872056 | 24,388904 | 25,312681 | 24,440900 | -115,362639 | 8,157172 | 8,163332 | 8,153834 | 8,169157 | 2,272659 | 2,197361 | 2,268356 | 12,003634
14-26-00_880 | C:\Users\au540322\Documents\Projects\Ice-Nucleation\Builds\Full Build\Data\Calibration_15/Images/14-26-00_880.PNG | -19,803353 | -19,808947 | -19,838415 | -19,871792 | 24,384471 | 25,311879 | 24,445182 | -114,758983 | 8,157189 | 8,163341 | 8,153846 | 8,169117 | 2,273026 | 2,197425 | 2,268002 | 12,003597
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
