Aarhus-University-MPE/Ice-Nucleation-Controller/docs/Calibration Data/Sensor 2,3,4/Calibration_16/Data.csv

Time [MM:SS] | Image file path | T1 | T2 | T3 | T4 | T5 | T6 | T7 | T8 | V1 | V2 | V3 | V4 | V5 | V6 | V7 | V8
15-02-06_334 | C:\Users\au540322\Documents\Projects\Ice-Nucleation\Builds\Full Build\Data\Calibration_16/Images/15-02-06_334.PNG | -24,731995 | -24,732619 | -24,762709 | -24,792611 | 24,618104 | 25,307792 | 24,833750 | -114,238764 | 8,875237 | 8,880543 | 8,871353 | 8,885304 | 2,253750 | 2,197753 | 2,236096 | 12,003563
15-02-06_834 | C:\Users\au540322\Documents\Projects\Ice-Nucleation\Builds\Full Build\Data\Calibration_16/Images/15-02-06_834.PNG | -24,731948 | -24,732504 | -24,762611 | -24,792628 | 24,618648 | 25,305704 | 24,832047 | -114,703301 | 8,875230 | 8,880527 | 8,871339 | 8,885306 | 2,253705 | 2,197920 | 2,236235 | 12,003594
15-02-07_334 | C:\Users\au540322\Documents\Projects\Ice-Nucleation\Builds\Full Build\Data\Calibration_16/Images/15-02-07_334.PNG | -24,731606 | -24,732465 | -24,762247 | -24,792559 | 24,619867 | 25,305979 | 24,827604 | -115,611498 | 8,875183 | 8,880522 | 8,871288 | 8,885297 | 2,253605 | 2,197898 | 2,236598 | 12,003648
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
