Aarhus-University-MPE/Ice-Nucleation-Controller/docs/Calibration Data/Sensor 2,3,4/Calibration_17/Data.csv

Time [MM:SS] | Image file path | T1 | T2 | T3 | T4 | T5 | T6 | T7 | T8 | V1 | V2 | V3 | V4 | V5 | V6 | V7 | V8
15-30-03_221 | C:\Users\au540322\Documents\Projects\Ice-Nucleation\Builds\Full Build\Data\Calibration_17/Images/15-30-03_221.PNG | -29,598296 | -29,594668 | -29,624399 | -29,652044 | 24,646291 | 25,323214 | 24,867768 | -115,015322 | 9,515970 | 9,520431 | 9,511790 | 9,524200 | 2,251435 | 2,196516 | 2,233324 | 12,003613
15-30-03_722 | C:\Users\au540322\Documents\Projects\Ice-Nucleation\Builds\Full Build\Data\Calibration_17/Images/15-30-03_722.PNG | -29,598639 | -29,594982 | -29,624631 | -29,651982 | 24,653263 | 25,330508 | 24,882406 | -115,717951 | 9,516012 | 9,520470 | 9,511818 | 9,524192 | 2,250863 | 2,195931 | 2,232131 | 12,003654
15-30-04_222 | C:\Users\au540322\Documents\Projects\Ice-Nucleation\Builds\Full Build\Data\Calibration_17/Images/15-30-04_222.PNG | -29,598952 | -29,594847 | -29,624968 | -29,652035 | 24,652798 | 25,334301 | 24,896370 | -115,958228 | 9,516051 | 9,520453 | 9,511860 | 9,524199 | 2,250901 | 2,195627 | 2,230995 | 12,003667
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
