Aarhus-University-MPE/Ice-Nucleation-Controller/docs/Calibration Data/231009_non_uniformity_correction_test2.xlsx

Well Name | Partition | Content | Freeze Temp | Frozen Fraction | T0...
Calibration Offset | Applied | - | - | - | -0.31548257 | -0.31747407 | -0.3086503 | -0.27152464 | -0.28420205 | -0.26340572 | -0.30815583 | -0.30401184 | -0.21815493 | -0.22298846 | -0.24464026 | -0.25203622 | -0.26111932 | -0.23361032 | -0.24138647 | -0.24326927 | -0.2155298 | -0.17821611 | -0.17590571 | -0.24515866 | -0.25921649 | -0.31464021 | -0.35474378 | -0.31419037 | -0.31983214 | -0.32770442 | -0.34124292 | -0.24529343 | -0.16152101 | -0.15316632 | -0.38477879 | -0.36479269 | -0.35142453 | -0.43270994 | -0.4295404 | -0.46812859 | -0.44768257 | -0.41853425 | -0.44003581 | -0.44791898 | -0.43807878 | -0.41122299 | -0.42393378 | -0.42978561 | -0.37870787 | -0.36684837 | -0.37896804 | -0.37575824 | -0.41552458 | -0.42414827 | -0.4301299 | -0.51928403 | -0.51843317 | -0.41195327 | -0.40711408
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
