Aarhus-University-MPE/Ice-Nucleation-Controller/docs/Calibration Data/231009_warmup_test_IR_cam.xlsx

Well Name | Partition | Content | Freeze Temp | Frozen Fraction | T0...
Calibration Offset | Applied | - | - | - | -0.61448452 | -0.63261721 | -0.7763175 | -0.71204212 | -0.65816494 | -0.73960778 | -0.73883202 | -0.67948244 | -0.63300075 | -0.61635682 | -0.62823514 | -0.65706909 | -0.75972116 | -0.71921476 | -0.77117555 | -0.35662978 | -0.36878175 | -0.39599163 | -0.36300536 | -0.39277423 | -0.42043523 | -0.41237897 | -0.38134371 | -0.44327671 | -0.46792325 | -0.49336737 | -0.39972266 | -0.46676043 | -0.48395472 | -0.45341041 | -0.47345444 | -0.55428867 | -0.47917863 | -0.58518556 | -0.58122287 | -0.55669804 | -0.59085347 | -0.58408968 | -0.58760514 | -0.56350991 | -0.4691606 | -0.52311488 | -0.52602925 | -0.58398232 | -0.54256806 | -0.52273099 | -0.58314934 | -0.6175682 | -0.57274503 | -0.65736079 | -0.56693364 | -0.64598624 | -0.58547439 | -0.56949002 | -0.56319479
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
