Aarhus-University-MPE/Ice-Nucleation-Controller/docs/Calibration Data/231010_vertical_gradient_data.xlsx

Sheet: lower position A24 + H12
Time_MM_SS | ImageFilePath | TRef_C | T1_C | T2_C | TRef_V | T1_V | T2_V | VRef_V | TRef_C | TRef_Gradient | Target_Temp | Target_Gradient
12-03-31_524 | C:\Program Files\Ice Nucleation Controller\Data\231010_vertical_gradient_A24_H12_lowerposition_new/Images/12-03-31_524.PNG | 4.391282928 | 6.77788193 | 7.090947662 | 4.433527078 | 8.179329346 | 8.143335768 | 4391283 | 11993457 | 0,001236 | -20000000 | -1000000
12-03-36_530 | C:\Program Files\Ice Nucleation Controller\Data\231010_vertical_gradient_A24_H12_lowerposition_new/Images/12-03-36_530.PNG | 4.388270155 | 6.768892463 | 7.080873883 | 4.433940258 | 8.180359255 | 8.14449335 | 4388270 | 11993454 | -0,019761 | -20000000 | -1000000
12-03-41_523 | C:\Program Files\Ice Nucleation Controller\Data\231010_vertical_gradient_A24_H12_lowerposition_new/Images/12-03-41_523.PNG | 4.353113138 | 6.758855791 | 7.074920924 | 4.43876591 | 8.181490671 | 8.145157942 | 4353113 | 11993423 | -0,454853 | -20000000 | -1000000
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
