Aarhus-University-MPE/Ice-Nucleation-Controller/docs/Calibration Data/Field/DryBlock Calibration.xlsx

 | PT100_001 |  |  | PT100_002 |  |  | PT100_003
Setpoint | T1 | R1 | E1 | T2 | R2 | E2 | T3 | R3 | E3 | Correction | T3_Corr | Remainder | Correction2 | T3_Corr2 | T3_Corr3
20 | 20.244 | 107.888 | 0.244 | 20.332 | 107.917 | 0.332 | 20.305 | 107.904 | 0.305 | 0.302720491 | 20.00227951 | 0.002279509049 | 0.3045849626 | 20.00041504 | 0.0004150373806
10 | 10 |  | 0 | 10 |  | 0 | 10.476 | 104.088 | 0.476 | 0.4588677656 | 10.01713223 | 0.01713223438 | 0.4692111894 | 10.00678881 | 0.006788810606
0 | 0 |  | 0 | 0 |  | 0 | 0.696 | 100.269 | 0.696 | 0.6919969247 | 0.004003075331 | 0.004003075331 | 0.7085047255 | -0.01250472553 | -0.01250472553
-10 | -10 |  | 0 | -10 |  | 0 | -9.043 | 96.459 | 0.957 | 0.9205542068 | -9.963554207 | 0.03644579323 | 0.9427146982 | -9.985714698 | 0.01428530181
-20 | -20 |  | 0 | -20 |  | 0 | -18.773 | 92.643 | 1.227 | 1.195109525 | -19.96810953 | 0.03189047468 | 1.239370348 | -20.01237035 | -0.01237034826
-25 | -25 |  | 0 | -25 |  | 0 | -23.537 | 90.766 | 1.463 | 1.395565297 | -24.9325653 | 0.06743470347 | 1.46862194 | -25.00562194 | -0.005621940365
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
