Aarhus-University-MPE/Ice-Nucleation-Controller/docs/Calibration Data/Vertical Gradient/Verticalgradienttest/Data.csv

Time_MM_SS | ImageFilePath | TRef_C | T1_C | T2_C | TRef_V | T1_V | T2_V | VRef_V | TRef_C | TRef_Gradient | Target_Temp | Target_Gradient
13-02-34_995 | C:\Program Files\Ice Nucleation Controller\Data\Verticalgradienttest/Images/13-02-34_995.PNG | 20.9622075640675831 | 24.9405583174294634 | 23.4217879487412688 | 2.5480404226804034 | 6.2408591652428615 | 6.2050504210621380 | 20,962208 | 11,993468 | -0,022553 | -30,000000 | -0,000000
13-02-39_979 | C:\Program Files\Ice Nucleation Controller\Data\Verticalgradienttest/Images/13-02-39_979.PNG | 20.9645781206981247 | 24.9428587220779150 | 23.3533005808484404 | 2.5478186933886224 | 6.2405686521869095 | 6.2130940087493665 | 20,964578 | 11,993424 | 0,019378 | -30,000000 | -0,000000
13-02-44_982 | C:\Program Files\Ice Nucleation Controller\Data\Verticalgradienttest/Images/13-02-44_982.PNG | 20.9628941788586971 | 24.9450485541967168 | 23.1468502404542846 | 2.5479338495691923 | 6.2402293229239785 | 6.2373426102008000 | 20,962894 | 11,993261 | 0,006012 | -30,000000 | -0,000000
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
