Aarhus-University-MPE/Ice-Nucleation-Controller/docs/assets/Experiment_Start.png

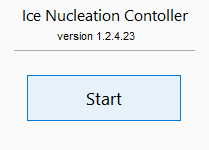
docs/assets/Experiment_Start.png
