Aarhus-University-MPE/Ice-Nucleation-Controller/docs/assets/RTC157_Calibrator.jpg

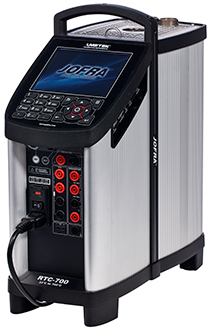
docs/assets/RTC157_Calibrator.jpg
