Aarhus-University-MPE/Ice-Nucleation-Controller/docs/assets/T_Residual_Calibrated_Vout_Plot.png

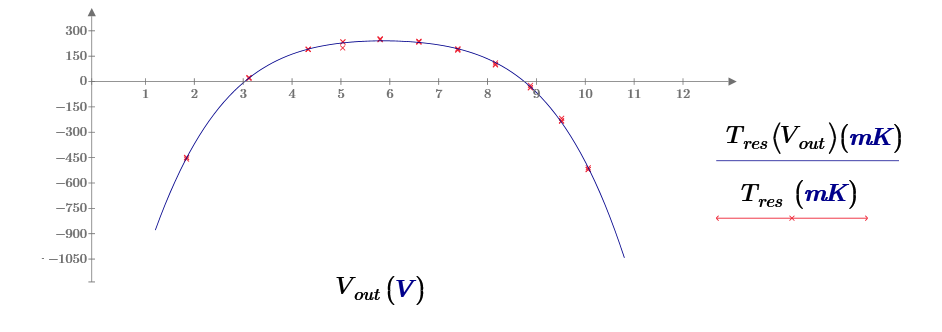
docs/assets/T_Residual_Calibrated_Vout_Plot.png
