Aarhus-University-MPE/Ice-Nucleation-Controller/docs/assets/T_Vout_Calibrated.png

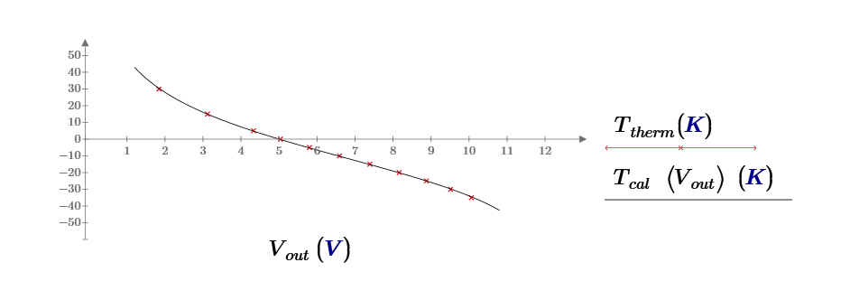
docs/assets/T_Vout_Calibrated.png
