Aarhus-University-MPE/Ice-Nucleation-Controller/docs/assets/Fix-point_Cavity.png

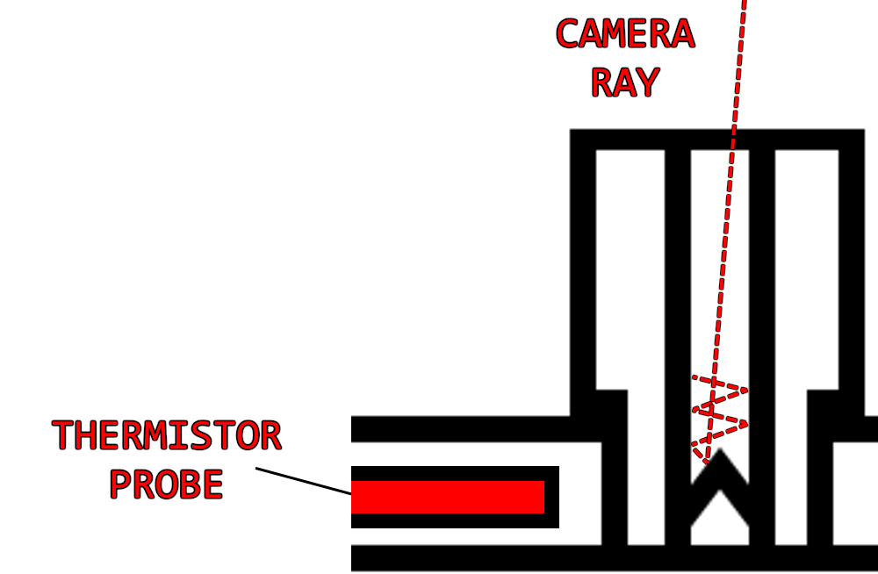
docs/assets/Fix-point_Cavity.png
