Aarhus-University-MPE/Ice-Nucleation-Controller/(threads)

Thread 1 (2022-04-04):

Heating Sometimes halts unexpected

MadsR, 2022-04-04:
Potentially timeout error

MadsR, 2022-12-11:
Expected to be due to timeout messages missed, not reported since last timeout update.

Closed 2022-12-11.

Thread 10 (2022-04-04):

Thermal FLIR camera reading inaccuracy

MadsR, 2022-04-04:
Current model uses the linear scale of FLIR cameras.

Using RAW camera values and calculating surface temperatures based on object parameters, might be more accurate.

Camera might be affected by a significant portion of the image not being the target.

- Copper base plate, PCR plate fills +80% of the image

MadsR, 2023-09-08:
**Radiometric Measurements**
*(https://www.flir.com/discover/security/radiometric/the-benefits-and-challenges-of-radiometric-thermal-technology/)*
A radiometric thermal camera measures the temperature of a surface by interpreting the intensity of an infrared signal reaching the camera.

**Procedure**
*(https://forums.ni.com/t5/Machine-Vision/FLIR-IR-Camera-A655sc-Greyscale-to-Temperature-Conversion/td-p/4146799)*

1) The camera can either give raw 16bit images and the software has to do the conversion itself with 3 steps:

- Subtract the global offset from each pixel and divide by gain (easy!)

- To the result, apply the universal thermography equation, with the object parameters (f****** hard and a lot of work!)

- To the result apply equation [2.2.4.8 from the GenICam](https://support.flir.com/DocDownload/Assets/dl/t559505-en-us.pdf) standard: Temperature (in Kelvin) = B / log(R / S + F), where S is the 16-bit digital signal value. log(x) is the base-e logarithm of the x parameter. (easy again!)

MadsR, 2023-11-28:
Conclusion was made to not change camera measurement model, to avoid overcomplicating temperature readings.

Instead focus should be directed to investigating camera (and object) parameters to ensure they have been set to values ideal for water surfaces (opened new issue as #58)

Thread 2 (2022-04-04):

Overhead Error keeps popping up

MadsR, 2022-04-04:
Popup should appear once, then stop system.

Unable to continue without closing and re-opening software

MadsR, 2022-12-12:
Will now only display error when temperature control is active.

Thread 3 (2022-04-04):

False overhead error

MadsR, 2022-04-04:
Will report false overhead error upon starting up.

First few measurements take slightly longer resulting in overhead error.

MadsR, 2022-12-12:
Will only display error when temperature control is currently active, which should remove this error completely.

Closed 2022-12-12.

Thread 4 (2022-04-04):

System cools too fast after melting

MadsR, 2022-04-04:
Adding a melt and hold functionality would be beneficial

1. Heat up to 40°C
2. Hold 40°C +/- x°C until stopped

Thread 7 (2022-04-04):

Well temperatures might be inaccurate due to well walls temperatures

MadsR, 2022-04-04:
Possible solutions:
---

Add **weighted readings** (center weighed more than perimeter)

Add **visible temperature readout** when selecting well radius
               -2.7
        -3.1 -3.0 -3.1
-2.7 -3.1 -3.2 - 3.1  -2.7
        -3.1 -3.0 -3.1
               -2.7

MadsR, 2023-09-20:
Moved pixel inspection tool to new issue #52

Thread 8 (2022-04-04):

System Air negative effect on measurements

MadsR, 2022-04-04:
Removing silica gel bags improved readings (closer to theoretical).

Adding low air flow further improved data.

High air flow, significantly improved data.

High air flow limits system minimum temperature to -23°C.

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

MadsR, 2022-12-11:
Air flow control added in issue #32, further tests will show results

Closed 2022-12-11.

Thread 9 (2022-04-04):

Approximating melting temperatures from freezing points inaccurate

MadsR, 2022-04-04:
Melting temperatures measured from freezing points were too inaccurate.

For accurate melting temperature, an inverse system test is needed.

- Can go higher temperature gradient than usual 1 K/min
- Passive heating from turned off system might be sufficient
- Might need slight cooling during **heating** to slow heating process

MadsR, 2022-06-10:
See #12

Closed 2022-06-10.

Thread 12 (2022-05-14):

Add melting point sample

MadsR, 2022-05-14:
Controlled heating (from -30°C to 0°C)

3 system tests

Standard cooling (5°C to -30°C
Cool and heat (5°C to -30°C to 0°C)
Heating (5°C rapid cool to -30°C to 0°C)

MadsR, 2022-06-10:
Theory behind measuring freezing point depression using a controlled melting is invalid, so the need for this feature does not currently exist.

Reason is because the salt is expelled from the ice matrix and will not cause a depression in melting temperature.

Closed 2022-06-10.

Thread 14 (2022-05-30):

wargning

MadsR, 2022-05-30:
### Ice-Nucleation-Controller version

4564

### Running as admin

- [ ] Yes

### Area(s) with issue?

Developer file preview

### Steps to reproduce

65464

### ✔️ Expected Behavior

123

### ❌ Actual Behavior

123

### Other Software

_No response_

Closed 2022-05-30.

Thread 16 (2022-06-10):

Temperature gradient reset when starting sample ø

MadsR, 2022-06-10:
### Ice-Nucleation-Controller version

1.2.11.52

### Area(s) with issue?

Ice Nucleation Controller, Temperature Controller

### Steps to reproduce

Starting experiment resets temperature gradient for +5 sec. Resulting in pid controller over shooting more than necessary.

### ✔️ Expected Behavior

Continue using gradient previously measured without resetting.

### ❌ Actual Behavior

Temperature gradient resets to 0 K/min for +5 sec.

Thread 17 (2022-06-10):

Temperature controller resetting when started from low temperature

MadsR, 2022-06-10:
### Ice-Nucleation-Controller version

1.2.11.52

### Area(s) with issue?

Ice Nucleation Controller, Temperature Controller

### Steps to reproduce

Starting system from a low temperature (aka currently high gradient)

### ✔️ Expected Behavior

Pid controller ramping up to achieve target gradient.

### ❌ Actual Behavior

PID controller constantly resetting integral part due to current gradient > 1.5 K/min.

Closed 2022-12-11.

Thread 18 (2022-06-10):

Timeout spam

MadsR, 2022-06-10:
### Ice-Nucleation-Controller version

1.2.11.52

### Area(s) with issue?

General

### Steps to reproduce

Heating timeout with new delay spams, add Bool to only send once.

### ✔️ Expected Behavior

_No response_

### ❌ Actual Behavior

_No response_

MadsR, 2022-12-11:
Timeout messages now limited to 1/sec

Closed 2022-12-11.

Thread 19 (2022-06-10):

Temperature controller evaluation feedback

MadsR, 2022-06-10:
### Description of the new feature / enhancement

If target temperature can not be reached (cooling at 100%) halt experiment and display error.

### Scenario when this would be used?

Under system failure, temperature gradient, temperature target too difficult to reach, avoids running system at 100% continuously with no chance of reaching temperatures.

Or if temperature measurement is incorrect, etc.

### Supporting information

_No response_

Thread 20 (2022-06-10):

Temperature control current check

MadsR, 2022-06-10:
### Description of the new feature / enhancement

Check if current draw is within reasonable limits, report error if outside.

### Scenario when this would be used?

If peltier element or relay control fails, shorted connections, or disconnected wires.

Avoids running with system failure.

### Supporting information

_No response_

Thread 22 (2022-06-10):

Verify relay switch happens before voltage

MadsR, 2022-06-10:
### Ice-Nucleation-Controller version

1.2.12

### Area(s) with issue?

Temperature Controller

### Steps to reproduce

Ensure relay switches only happen with PSU output off.

### ✔️ Expected Behavior

_No response_

### ❌ Actual Behavior

_No response_

MadsR, 2022-10-19:
Verified and validated

Closed 2022-10-19.

Thread 23 (2022-06-10):

Peltier element underperforming

MadsR, 2022-06-10:
### Ice-Nucleation-Controller version

1.2.12

### Area(s) with issue?

Hardware Issue, Temperature Controller

### Steps to reproduce

Peltier element underperforming.

Peltier element left in frame, furthest away from fix point cavity, and the element that was connected to the faulty relay.

Struggling to reach - 30°C, will struggle even further with constant air flow.

### ✔️ Expected Behavior

_No response_

### ❌ Actual Behavior

_No response_

MadsR, 2022-06-21:
System was able to reach -25°C with air flow as previously.

**Planned service**
Start of August

- Replace faulty peltier element
- Rework cables to not have connections below cooling block

MadsR, 2022-06-24:
Performance significantly halted, potentially not working at all.

While melting:
18.2V, 7.3A

MadsR, 2022-10-19:
Peltier element replaced, found faulty connection during inspection, minor manipulation and connection broke.

Will verify performance during system test 21-10

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

MadsR, 2022-10-21:
The second peltier element was also damaged during inspection, and has been replaced

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

Performance issues has also been observed as being related to the thermal anchoring between the peltier element and the water coolers. During service fresh thermal pads were missing, so thermal pads were reused, but the thermal anchoring proved insufficient.

New thermal pads has to be ordered, peltier elements cleaned and applied fresh thermal pads.

MadsR, 2022-11-01:
During disassembly one of the peltier elements had plastic covered layer still attached to the cooling pad.

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

MadsR, 2022-12-12:
After service system performance is again up to standards.

Water cooling loop has been reduced to 2°C (previously 5°C), and both peltier elements has been replaced.

System tests (without air flow) shows -30°C temperatures reached with a peak at 65% cooling.

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

Closed 2022-12-12.

Thread 24 (2022-06-14):

Half cooling performance

MadsR, 2022-06-14:
### Ice-Nucleation-Controller version

1.2.11

### Area(s) with issue?

Hardware Issue, Temperature Controller

### Steps to reproduce

System suddenly at half cooling capability.

Lowest possible temperature at -15°C

### ✔️ Expected Behavior

Usual lowest possible temperature is between -30°C and -35°C

### ❌ Actual Behavior

System stuck at -15°C and at 100% cooling output.

Thread 25 (2022-06-14):

PID controller too aggressive during start

MadsR, 2022-06-14:
### Ice-Nucleation-Controller version

1.2.12

### Area(s) with issue?

Ice Nucleation Controller, Temperature Controller

### Steps to reproduce

When starting new measurement, temperature controller peaks to 100%.

### ✔️ Expected Behavior

Slow and steady increase with minimal overshoot.

### ❌ Actual Behavior

Overshot significant.

~5K/min overshoot

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

Thread 26 (2022-06-21):

System Over Current while Melting/Cooling

MadsR, 2022-06-21:
### Ice-Nucleation-Controller version

1.2.12

### Area(s) with issue?

Ice Nucleation Controller, Hardware Issue, Temperature Controller

### Steps to reproduce

Followed standard procedure to melt Gallium, temperature stuck at 30°, then started cooling.
PSU reported Over Current and sits at 1V 30A when cooling or heating.

**Possible Cause**
Faulty peltier element broke down causing a short circuit.
Alternatively faulty relay wiring.

### ✔️ Expected Behavior

_No response_

### ❌ Actual Behavior

_No response_

MadsR, 2022-06-21:
**Conclusion**
System was inspected and no flaws found, unable to reproduce error.
Cooling and heating capabilities were at 90%. One peltier element underperforming slightly as described in #23.

Closed 2022-06-21.

Thread 27 (2022-06-24):

PSU 1V 30A

MadsR, 2022-06-24:
### Ice-Nucleation-Controller version

1.2.12

### Area(s) with issue?

General, Ice Nucleation Controller, Hardware Issue

### Steps to reproduce

PSU output: 1V 30A.
Running system normally, any PSU output results in 1V 30A.

Hard to reproduce.

### ✔️ Expected Behavior

_No response_

### ❌ Actual Behavior

_No response_

MadsR, 2022-06-26:
**Cause**
Shorted connection in WAGO connectors below cooling block.

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

Replaced and repaired connections, moved away from area of high condensation

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

MadsR, 2022-07-06:
**05-07**
Error reported again, restarting PSU resolved error.

**Todo**
Redo electrical connections and replace peltier element, should fix shorted connection somewhere in the system.

MadsR, 2022-09-23:
Error reported again 22-09-2022

MadsR, 2022-09-23:
Fixed for now by removing and reinserting Relays

MadsR, 2022-09-26:
Potential common ground issue.
Can add pull-down resistor.

MadsR, 2022-10-19:
System double-checked and rewired, added pull-down resistor. Awaiting validation during system test.

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

MadsR, 2022-12-11:
**100VDC/30A Solid State Relays Replacements**
After new Solid State relays rated for DC current error has been resolved. Control circuit and commands altered slightly, described in release 1.2.14

https://github.com/Aarhus-University-MPE/Ice-Nucleation-Controller/releases/tag/v1.2.14

Closed 2022-12-11.

Thread 28 (2022-09-13):

Frozen Fraction Always scale to 1

MadsR, 2022-09-13:
### Ice-Nucleation-Controller version

1.2.12

### Area(s) with issue?

Freezing Point Detection

### Steps to reproduce

When wells don't freeze, the frozen fraction should still go up to 1

### ✔️ Expected Behavior

_No response_

### ❌ Actual Behavior

_No response_

MadsR, 2022-10-19:
Reworked and implemented in latest update, will be released in version 1.2.13

Closed 2022-10-21.

Thread 29 (2022-09-13):

Top Freeze

MadsR, 2022-09-13:
### Ice-Nucleation-Controller version

1.2.12

### Area(s) with issue?

Freezing Point Detection

### Steps to reproduce

Unsure if Freezing point uses largest Gradient

### ✔️ Expected Behavior

_No response_

### ❌ Actual Behavior

_No response_

MadsR, 2022-10-19:
Confirmed and validated, freezing point detection uses largest Gradient

Closed 2022-10-19.

Thread 30 (2022-09-13):

Move Freeze point

MadsR, 2022-09-13:
### Ice-Nucleation-Controller version

1.2.12

### Area(s) with issue?

Freezing Point Detection

### Steps to reproduce

Move freeze index to lowest temperature not highest gradient.

### ✔️ Expected Behavior

_No response_

### ❌ Actual Behavior

_No response_

MadsR, 2022-10-19:
Reworked and available in latest update, planned for version 1.2.13

MadsR, 2022-10-21:
Added in release https://github.com/Aarhus-University-MPE/Ice-Nucleation-Controller/releases/tag/v1.2.13

Closed 2022-10-21.

Thread 31 (2022-10-04):

Cooling -> Heating -> Cooling cycle

MadsR, 2022-10-04:
### Description of the new feature / enhancement

Implement heating functionalities into sampling.

Example temperature:

start: 10°C
Cool -> -30°C
Heat -> 70°C
Cool -> -30°C
Heat -> 120°C
Cool -> -30°C
Heat -> 200°C
Cool -> -30°C

### Scenario when this would be used?

Periodic healing->cooling->heating experiments.

### Supporting information

Structural frame of system is currently 3D printed, which won't survive the high temperatures.

Additionally cold water circulator will overpower peltier elements if circulated resulting in a maximum temperature below 200°C.

**Tasks:**

- Add by-pass valve
- Redesign structural frame to survive high temperatures

Closed 2023-11-06.

Thread 32 (2022-10-19):

Implement Air Flow control to system

MadsR, 2022-10-19:
### Description of the new feature / enhancement

As described in #8, flushing the tower with dry air affects the results. Implementing a controlled air flow to the system allows for conducting and quantifying the impact of dry air in the chamber.

### Scenario when this would be used?

To verify and validate dry air impact on data.

### Supporting information

Condensation potentially starting nucleation process earlier, dry air will reduce condenstaion in the chamber.

MadsR, 2022-10-19:
Air flow control added to system, remaining installation planned for 21-10.

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

MadsR, 2022-12-11:
**Air Flow Installation**
Air flow modifications has been installed.

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

Closed 2022-12-11.

Thread 33 (2022-10-21):

Copper Leak from Water Cooler

MadsR, 2022-10-21:
### Ice-Nucleation-Controller version

1.2.13

### Area(s) with issue?

General, Hardware Issue

### Steps to reproduce

Copper-like leakage was observed on the water cooler filters. Assumed to be from an internal component that had rubbed thermal insulation against the filter.

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

### ✔️ Expected Behavior

_No response_

### ❌ Actual Behavior

_No response_

MadsR, 2022-10-21:
A layer of rubber pad was attached to the thermal insulation to cover the exposed copper.

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

Closed 2022-10-21.

Thread 38 (2022-12-08):

Over Voltage Error

MadsR, 2022-12-08:
### Ice-Nucleation-Controller version

1.2.14

### Area(s) with issue?

Hardware Issue

### Steps to reproduce

System test after installing new solid state relays, psu reporting Over Voltage and kicks into OV protection.

### ✔️ Expected Behavior

_No response_

### ❌ Actual Behavior

_No response_

MadsR, 2022-12-08:
Could be caused by polarity swap during cooling.
Shouldn't timeout during cooling.

Switching duration might be longer than set value.

MadsR, 2022-12-11:
**Solution**

Closed 2022-12-11.

Thread 39 (2022-12-11):

Air Flow pressure above connections capabilities

MadsR, 2022-12-11:
### Ice-Nucleation-Controller version

1.2.14

### Area(s) with issue?

Hardware Issue

### Steps to reproduce

When opening air flow, pressure builds higher than tube connections can withstand.

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

### ✔️ Expected Behavior

_No response_

### ❌ Actual Behavior

_No response_

MadsR, 2023-11-28:
**Update**
Flow restrictor currently not in use. New lab will have built-in flow restrictor with readout.

Closed 2023-11-28.

Thread 40 (2022-12-12):

Add Melt/Freeze buttons to main layout

MadsR, 2022-12-12:
### Description of the new feature / enhancement

Add two primary buttons to main layout does the same as Tools>Temperature>Melt/Freeze

### Scenario when this would be used?

To more easily access melting and freezing functionalities, which are used constantly.

### Supporting information

_No response_

MadsR, 2022-12-12:
Added Melt and Freeze Buttons.

Hides when currently active logging, freezing or melting.

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

Closed 2022-12-12.

Thread 42 (2023-01-16):

Clumps in Gallium

MadsR, 2023-01-16:
### Ice-Nucleation-Controller version

1.2.14

### Area(s) with issue?

General, Hardware Issue

### Steps to reproduce

Clumps accumulate over time until it becomes significant.

Potentially a reaction with some contaminate.

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

### ✔️ Expected Behavior

_No response_

### ❌ Actual Behavior

_No response_

MadsR, 2023-11-06:
**Possible Reason**
Could be due to dust on bottom of PCR plate or other contaminants build-up in Gallium.

**Solution**
Remove contaminants and refill gallium when level is low

Closed 2023-11-06.

Thread 43 (2023-02-20):

Temperature jumps in Camera Readings

MadsR, 2023-02-20:
### Ice-Nucleation-Controller version

1.2.14

### Area(s) with issue?

Thermal Camera Evaluation

### Steps to reproduce

Temperatures jump suddenly around -10 degrees

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

Potentially related to #10

Originally detected when inspecting calibration offsets
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

### ✔️ Expected Behavior

_No response_

### ❌ Actual Behavior

_No response_

MadsR, 2023-09-18:
Can be related to #49

Thread 44 (2023-09-06):

System Temperature Spikes

MadsR, 2023-09-06:
### Ice-Nucleation-Controller version

1.2.15.8

### Area(s) with issue?

Hardware Issue

### Steps to reproduce

Power up system, connect USB and Start Software

### ✔️ Expected Behavior

Stable temperature readings.

### ❌ Actual Behavior

Significant jumps or NaN in system temperature readings.

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

MadsR, 2023-09-06:
**Explanation**
Error is due to temperature measurement circuit not being powered, resulting in voltage readings being ~0.

**Solution**
Implement check if reference voltage is not within expected range, supply error.
"Check power supply", "Contact technician", "etc."

**Potential Failure**
If ignored, and operator starts using cooling/heating, system could overheat due to no failsafe in temperature readings.

MadsR, 2023-09-08:
**Simple Solution**
Document this error in the _Common Errors_ in the manual

Closed 2023-11-28.

Thread 45 (2023-09-07):

Vertical Gradient Uncertainty Test

MadsR, 2023-09-07:
### Description of the new feature / enhancement

Implement additional thermistor measurements, used for data collection (not system control)

### Scenario when this would be used?

Used for validating vertical gradient in PCR plates

### Supporting information

_No response_

MadsR, 2023-09-08:
**Additional Thermistor Implementation**
Reworked Thermistor calibration options.

- Added specific reference thermistor

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

- Added secondary thermistor settings

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

- Reworked Sensor readout clarity

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

**Example with T1 and T3 enabled**
Datafile now contains secondary thermistor data.
```
Time_MM_SS | ImageFilePath | TRef_C | T1_C | T3_C | TRef_V | T1_V | T3_V | VRef_V | TRef_C | TRef_Gradient | Target_Temp | Target_Gradient
```

_**Note**_
New data file might not be compatible with Thermal Camera Evaluation software (Data read).

MadsR, 2023-11-28:
Several vertical gradient tests have been conducted and is being described in the latest publication.

**System Parameters**

Standard measurement protocol.
•	Water Cooler at 2°C
•	Cooling Gradient: 1 °C/min
•	Target Temperature: -20  °C

**Procedure**
1.	Fill PCR plate with 30  mL
a.	At minimum fill 2 wells around thermistor probe wells (See Figure 2).
2.	Insert secondary thermistors at bottom depth (See Figure 1).
a.	Make sure not to touch sides/bottom of PCR plastic.
3.	Conduct standard measurement.
4.	Raise thermistors to the middle of the liquid.
5.	Conduct standard measurement.
6.	Raise thermistors to the top of the liquid (while still fully submerged).
7.	Conduct standard measurement.

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

**Micro Manipulator**
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

MadsR, 2023-11-28:
Latest results:

**Central G13**
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

**Corner A24**
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

**Corner B24**
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

MadsR, 2023-11-28:
**Notes**
These measurements were done at a top position (within the water and sufficiently anchored).
2nd point was measured 1.5 mm below the first point and the 3rd point was an additional 1.5 mm below.

The total water volume is approximately 8 mm. Meaning only a central 3 mm is measured.
Thoughts should be put into increasing (potentially extrapolating) the data to better estimate the total gradient.

Measurements beyond these three points result in interference from either contact with plastic wall or air near the surface.

Thread 46 (2023-09-07):

Camera Distortion Uncertainty Test

MadsR, 2023-09-07:
### Description of the new feature / enhancement

Implement large plate allowing for movement of Thermal Camera.

### Scenario when this would be used?

Used to validate camera lens distortion for uncertainty tests.

### Supporting information

_No response_

MadsR, 2023-09-12:
Plate has been installed on system ready for conducting Camera Lens Distortion experiments.

MadsR, 2023-09-18:
Implemented in Release v1.3.1
https://github.com/Aarhus-University-MPE/Ice-Nucleation-Controller/releases/tag/v1.3.1

Closed 2023-09-18.

Thread 48 (2023-09-18):

Unable to Re-select Image

MadsR, 2023-09-18:
### Ice-Nucleation-Controller version

1.3.0

### Area(s) with issue?

Thermal Camera Calibration

### Steps to reproduce

After completing 1 calibration, unable to complete second image Calibration without reopening TCC

### ✔️ Expected Behavior

_No response_

### ❌ Actual Behavior

_No response_

MadsR, 2023-09-18:
Implemented in Release v1.3.1
https://github.com/Aarhus-University-MPE/Ice-Nucleation-Controller/releases/tag/v1.3.1

Closed 2023-09-18.

Thread 49 (2023-09-18):

Automatic Non Uniformity Correction Uncertainty Interferrence

MadsR, 2023-09-18:
### Ice-Nucleation-Controller version

1.3.0

### Area(s) with issue?

Hardware Issue, Other

### Steps to reproduce

When doing Uncertainty measurements, automatic Non Uniformity Correction (NUC) interferes with measurements, resulting in large jumps in temperature correction, mid-experiment.

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

### ✔️ Expected Behavior

_No response_

### ❌ Actual Behavior

_No response_

MadsR, 2023-09-18:
**Possible Solution 1**
Adding a function to disable automatic NUC.

**Possible Solution 2**
Manually run NUC before experiment start.
Still makes it difficult to compare between experiments.

MadsR, 2023-09-18:
**Implemented in Release v1.3.1**
https://github.com/Aarhus-University-MPE/Ice-Nucleation-Controller/releases/tag/v1.3.1

Strategy still to be determined.

MadsR, 2023-10-03:
**Supporting Material**
https://www.flir.com/discover/professional-tools/what-is-a-non-uniformity-correction-nuc/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,interfere%20with%20its%20temperature%20readings.

https://www.flir.com/support-center/instruments2/how-do-i-manually-control-the-nuc-auto-calibration-in-the-flir-a35-and-a65/

MadsR, 2023-11-28:
NUC impact is added to the uncertainty calculations of the system.

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

Thread 50 (2023-09-18):

Temperature Controller Uncertainty Interference

MadsR, 2023-09-18:
### Ice-Nucleation-Controller version

1.3.0

### Area(s) with issue?

Temperature Controller

### Steps to reproduce

Automatic temperature controller interfering with Uncertainty measurements.

When trying to keep system at steady-state the automatic temperature controller will engage even if 0 K/min is set.

### ✔️ Expected Behavior

_No response_

### ❌ Actual Behavior

_No response_

MadsR, 2023-09-18:
**Solution**
Disable PSU and Relays when target gradient is set to 0 K/min on startup.

MadsR, 2023-09-18:
Implemented in Release v1.3.1
https://github.com/Aarhus-University-MPE/Ice-Nucleation-Controller/releases/tag/v1.3.1

Closed 2023-09-18.

Thread 52 (2023-09-20):

Pixel Temperature Inspection Tool

MadsR, 2023-09-20:
### Description of the new feature / enhancement

Add visible temperature readout when selecting well radius
---------- -2.7
----- -3.1 -3.0 -3.1
-2.7 -3.1 -3.2 - 3.1 -2.7
----- -3.1 -3.0 -3.1
---------- -2.7

### Scenario when this would be used?

During Thermal Camera Calibration.

### Supporting information

_No response_

MadsR, 2023-09-20:
**Inspection Tool**
Implemented in Thermal Camera Calibration (TCC) Software, allowing for inspecting individual pixel temperatures for better understanding of temperature variations and

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

Closed 2023-11-06.

Thread 53 (2023-09-20):

Reduce minimum Pixel Radius

MadsR, 2023-09-20:
### Description of the new feature / enhancement

Current minimum radius for TCC software is set to 3.

**Radius 3**
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

### Scenario when this would be used?

To reduce wall implications during temperature processing and inspection.

### Supporting information

_No response_

MadsR, 2023-11-06:
Added in release 1.3.1.16

Closed 2023-11-06.

Thread 54 (2023-10-03):

Re-calibration of fixpoint thermistor

MadsR, 2023-10-03:
### Provide a description of requested docs changes

Conducting a re-calibration of the fixpoint thermistor is required to determine long-term drift.

Thread 57 (2023-11-28):

Implement manual NUC features

MadsR, 2023-11-28:
### Description of the new feature / enhancement

Implement a feature to automatically run NUC (described in #49) to the start of every sample.
Additionally add a manually set interval for NUC, instead of only relying on built-in NUC intervals.

Current automatic NUC happens roughly every 15 minutes.

Reducing interval might improve camera reading accuracy.

### Scenario when this would be used?

Every sample, happening automatically.
Setting NUC interval based on experience and prior tests.

### Supporting information

https://www.flir.com/discover/professional-tools/what-is-a-non-uniformity-correction-nuc

Thread 58 (2023-11-28):

Investigate camera (and object) parameters

MadsR, 2023-11-28:
### Provide a description of requested docs changes

Investigating camera (and object) parameters to ensure they have been set to values ideal for water surfaces.

As stated in (https://flir.custhelp.com/app/answers/detail/a_id/1021/~/temperature-linear-mode) using linear camera model is fine, but an important factor is to ensure object parameters are set correctly (emissivity, distance)

A significant portion of errors are corrected for due to the presence of the reference thermistor, but triple checking camera parameters might improve accuracy.

Thread 59 (2023-11-28):

Add circuit power missing to common errors

MadsR, 2023-11-28:
### Provide a description of requested docs changes

#44 reported several times of unstable temperature readings.

Error is due to measuring circuit not being powered. Adding this description to the user manual should reduce the frequency of this failure.

Alternatively adding a software check to see if reference voltage is sufficient, and displaying an error in case of insufficient voltage.

Thread 60 (2023-11-29):

Update Galium Level Indicator Description

MadsR, 2023-11-29:
### Provide a description of requested docs changes

Update the recommended Galium level indicator.

Current manual recommends galium levels to look like
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

New tests show a possible filling to look like:
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

This level significantly improves overall thermal anchoring.

Thread 61 (2023-11-29):

Improve Gallium flow space around sides of PCR Plate

MadsR, 2023-11-29:
### Ice-Nucleation-Controller version

1.3.1

### Area(s) with issue?

Hardware Issue

### Steps to reproduce

Current cooling base top (B) has issues near the top/bottom portion closest to the wall.

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

### ✔️ Expected Behavior

Gallium should be perfectly surrounding the PCR wells as seen near the left/right side of the cooling base.
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

### ❌ Actual Behavior

Gallium does not fully surround the PCR wells near the top/bottom row.
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
