Aarhus-University-MPE/Ice-Nucleation-Controller/src/Python/figure.pdf

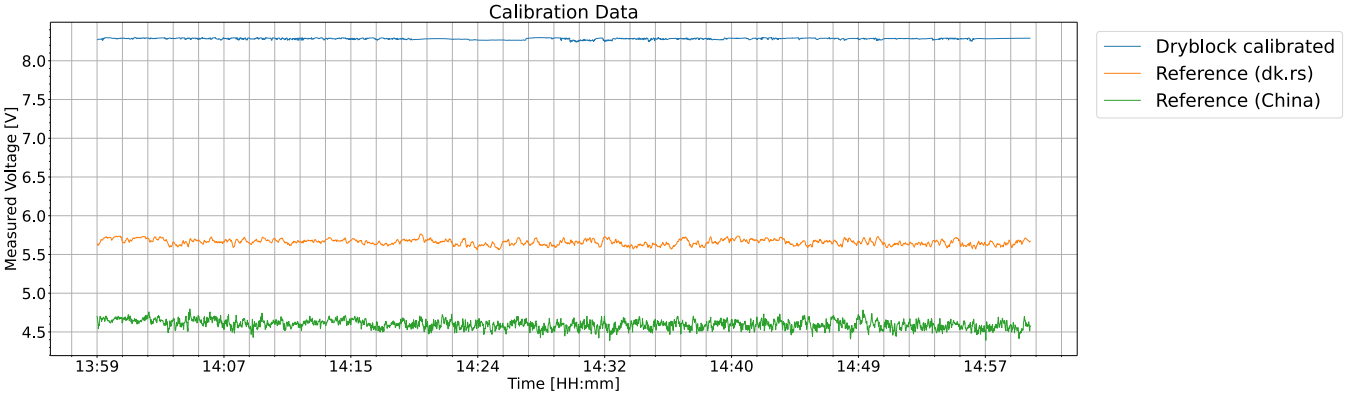
[picture p76: page 1]
