Aarhus-University-MPE/Ice-Nucleation-Controller/src/Arduino/INCField/Test/LCD/Encoder/Encoder.ino

#include "EncoderStepCounter.h"

#define ENCODER_PIN1 2
#define ENCODER_INT1 digitalPinToInterrupt(ENCODER_PIN1)
#define ENCODER_PIN2 3
#define ENCODER_INT2 digitalPinToInterrupt(ENCODER_PIN2)

int16_t position = 0;

// Create instance for one full step encoder
EncoderStepCounter encoder(ENCODER_PIN1, ENCODER_PIN2);
// Use the following for half step encoders
// EncoderStepCounter encoder(ENCODER_PIN1, ENCODER_PIN2, HALF_STEP);

void setup() {
  Serial.begin(115200);

  // Initialize encoder
  encoder.begin();

  // Initialize interrupts
  attachInterrupt(ENCODER_INT1, interrupt, CHANGE);
  attachInterrupt(ENCODER_INT2, interrupt, CHANGE);
}

// Call tick on every change interrupt
void interrupt() {
  encoder.tick();
}

// This is an example on how to change a "long" variable
// with the library. With every loop the value is added
// and then cleared in the encoder library
void loop() {
  signed char pos = encoder.getPosition();
  if (pos != 0) {
    position += pos;
    encoder.reset();
    Serial.println(position);
  }
}
