Aarhus-University-MPE/Ice-Nucleation-Controller/(commit log)

2021-06-10 Version 0.0.1
    [Data.csv, Setup.csv]
2021-06-11 Therrmistor conversion, Calibration setup
    [Data.csv, Setup.csv]
2021-06-14 Full version 0.0.1
    [Data.csv, Setup.csv]
2021-06-15 Manual Voltage control
    Added voltage control
    Changed channels to specified cDAQ
2021-06-18 Version 0.0.0.1
    Added notes from meeting and slight alterations
    [Data.csv, Setup.csv]
2021-06-30 Preliminary full version + Calibration data
    [32Setup.prt, Big Setup.prt, Data.csv, Data2.csv, Data3.csv, Data4.csv, Partition Setup.prt, Setup.csv]
2021-06-30 Last calibration data
    [Data.csv]
2021-07-01 .gitignore and calibration data
    Added gitignore file (exclude /Installer)
    Calibration data from remaining thermistors.
    [Data.csv, Data3.csv, Data4.csv, Setup.csv]
2021-07-12 Setup and Partition files
    [Data.csv, Partition.csv, Setup.csv]
2021-07-22 Calibration Data
    [Data.csv, Setup.csv]
2021-08-19 Data Calibration
    [Data.csv, Partition.csv, Setup.csv]
2021-09-07 Software Update
    [32Setup.prt, Big Setup.prt, Data.csv, Partition Setup.prt, Partition.csv, Setup.csv, Small Setup.prt, dfhsfdh.prt]
2021-09-13 PID Setup
    [Data.csv, Partition.csv, Setup.csv]
2021-09-20 Update
    Added manual sensor readout while datalogging
    PID Auto tuning
    [CentralWater.prt]
2021-09-27 Reworked data representation
    [32Setup.prt, CentralWater.prt, Partition Setup.prt, dfhsfdh.prt, test.prt]
2021-10-08 IR Camera
2021-10-25 Thermal Camera Update
2021-11-04 Thermal Camera Stream
2021-12-12 Data Cleanup
    [Data.csv, Partition.csv, Setup.csv]
2022-01-14 v1.2.4 Arduino Control
2022-01-14 Arduino Control
2022-01-24 Manual and Minor Software Tweaks
    [Big Setup.prt, Small Setup.prt]
2022-01-24 Clear Build Folder
    [Big Setup.prt, Data.csv, Partition.csv, Setup.csv, Small Setup.prt]
2022-01-25 docs assets
    [Data.csv, Partition.csv, Setup.csv]
2022-01-25 CPU Overhead and Sample Rate Modifications
2022-01-27 Performance Debug Tools
    Updated CPU Debug Tools
    - Shows Graph of Data Acquisition Overhead and Data Logging Process Time
    - Camera Image Frequency changed to fit divisible by 60 rule
2022-06-10 Updated Timeout Function
    Added delay from timeout till heating is turned off.
    Reason: Avoid Relay Sparks, might have caused relay failure.
2022-12-07 Solid State Relay Update
2022-12-07 Relay Control Modification
2022-12-07 versuib 1.2.14 Relay Control Rework
2022-12-08 Relay Control
    Correctly activate cooling relays when starting sample
2023-05-21 PiD variables
2023-05-23 System Installation
    [DryBlock Calibration.xlsx]
2023-05-25 PID Controller Rework
2023-09-08 Initial Uncertainty Test Additions
    Added Camera Mode selection
    Added Secondary Thermistor implementation
2023-09-08 Create Thermistor Calibartion.txt
2023-09-11 Version 1.3.0 Update
    Camera Mode Select,
    Additional Theremistor Reading,
    System Label Check (Special Characters)
2023-09-13 Added Build Bat files
    automatically extract and run install files
    [configFull.txt, configUpdate.txt]
2023-09-18 Uncertainty Interference
    Auto NUC toggle RTM
    Manual NUC cmd RTM
    PSU and Relay disabled on experiment start if Gradient 0 K/min
    TCC, added RTM to allow multiple calibrations without reopening.
2023-11-06 v1.3.1.16
    Minor bugfixes and functional implementations
    [Data.csv, Partition.csv, Setup.csv]
2025-05-01 Images of the silica plate and snowmax droplets
    YES
    [LabVIEWTestDataArray.csv, TestDataArray.csv]
2025-05-16 Safe pre PID addition
    [TestDataArray.csv]
2025-05-27 File ignore
    [TestDataArray.csv]
2025-07-03 There is a small error
    Whenever the sampling loop is active, the powersupply is not outputting the correct power level.
2025-07-30 PID fixes
    Still not werry good
2025-08-01 Wierd shit
    Plus PID
2025-08-01 Still working on PID and lables
2025-08-06 Solved some issues
    PID shit is the last step.
2025-08-07 More PID
2025-08-11 PID start at 5deg.
2025-09-23 Not note worthy
    [Freezing_points.csv, Sample_data.csv]
2025-09-23 Incoorporration of the pt100 thermistor to main code
    This is long overdue
2025-09-25 Heating safety
2026-01-07 Update to save the temps
    The mean temp and the temperatures used for calculating the offset should be saved.
2026-08-24 Changes to partitions
    The partitions ware not working properly and there is still an error making them wrong when the data file is generated.
    [Partition Setup.prt]
2026-09-17 Change to PID controll
    The Gradiant had a flip sign function attached, that did not work.
2026-09-17 Error with PID control
    The gradiant ware flipped sign.
2026-10-01 Error with partitions
    Crossed wire with partition labels.
